SeunOjuoko/AssemblyRobot/Photos/20220331_133813.jpg

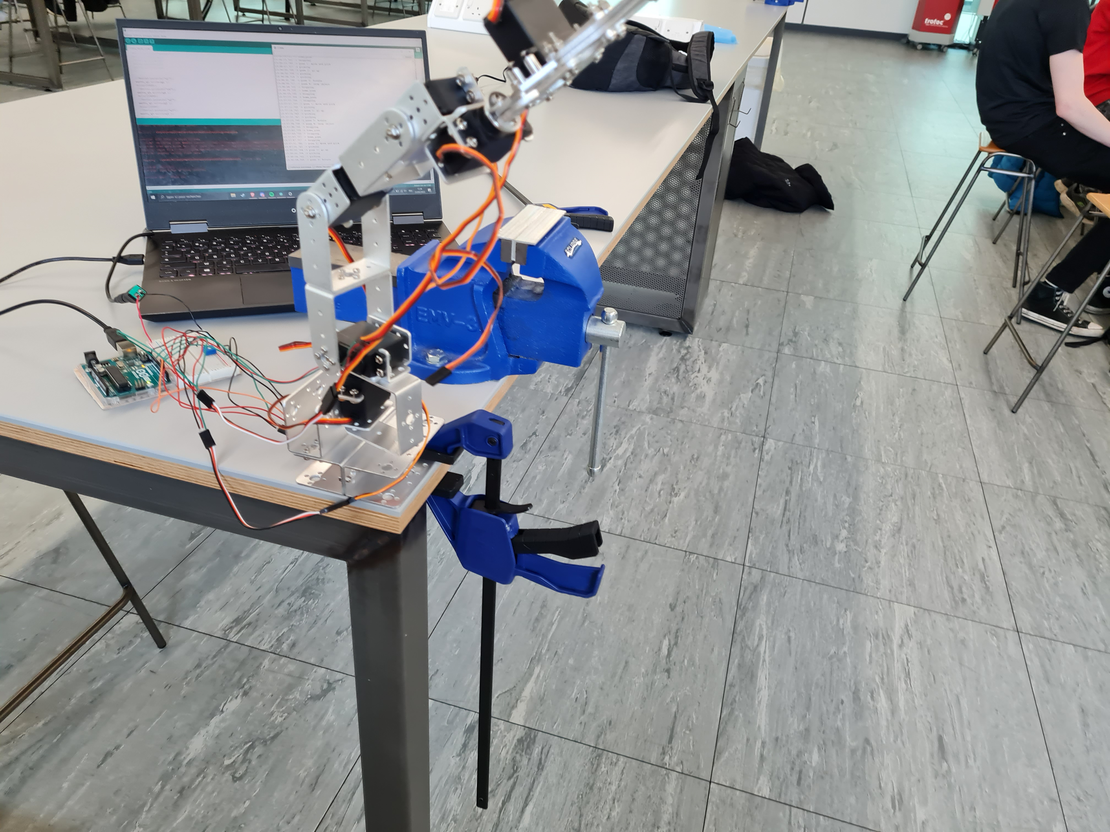
Photos/20220331_133813.jpg
