SeunOjuoko/AssemblyRobot/Photos/20220331_133640.jpg

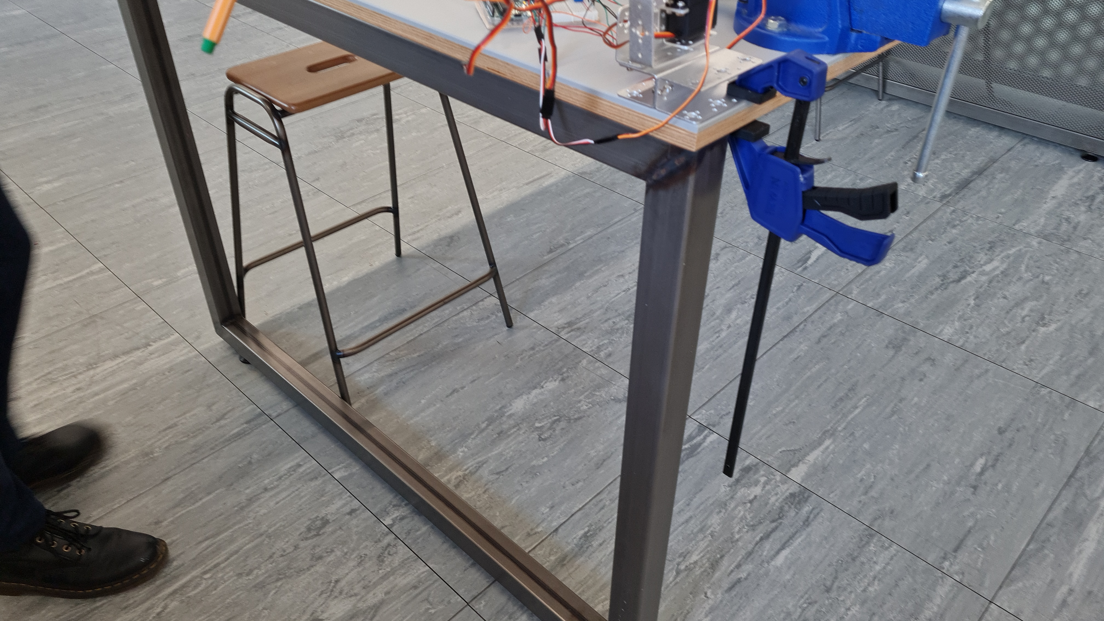
Photos/20220331_133640.jpg
