SeunOjuoko/AssemblyRobot/Electronic design link.txt

Link of the Electronic design:

https://www.tinkercad.com/things/bi56mNBK6sZ-casestudyarm/editel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
