SeunOjuoko/AssemblyRobot/More Questions for Kong.docx

1. Does the robot need to be less than £40 in parts, or is that the available budget for ordering extra parts? e.g. if we source our own servos (worth £20) and then buy a controller for £30, the robot will cost £50. Does this satisfy the requirement of the case study?
2. On that point, where can we source some spare controllers (Arduino etc.) from the uni? We've considered that the price of the controller will be a large part of the budget so would like to cut the cost.
