SeunOjuoko/AssemblyRobot/Report Plan.xlsx

Sheet: Current
Section | Description | Assigned Member(s) | Status | Notes
Abstract | -
Table of Contents | -
 |  |  |  |  | NOTE:
Introduction | Includes design brief, outline specific task, use diagrams/CAD models. | Adrian |  |  | (Adrian) I haven't really bothered to update this sheet, might just be easier to do what we did on the presentation and leave names on each section in the report.
Design 1? | Basic run through of the design, explain why rejected | Adrian
Design 2? | Basic run through of the design, explain why rejected
Design 3? | Basic run through of the design, explain why rejected | Xander
Decision Matrix |  | Adrian
Design
Chosen Design: Arm Config |  | Xander
Chosen Design: End Effector |  | Xander
some more stuff? |  | Xander
Fabrication
Material Selection |  | Xander
Fabrication/Assembly Process |  | Adrian
Costing/Bill of Parts |  | Bethany
Control
code |  | Sylvain
Simulating through tinkercad |  | Sylvain
choosing servo's |  | Zeon
choosing control board |  | Zeon
Analysis
D-H link parameters |  | Adrian
Link homogenous transformation matrix |  | Bethany
Forward Kinematics |  | Bethany
Inverse Kinematics |  | Bethany
Velocity Analysis
Static Analysis
Workspace Analysis
Robot Dynamics
Trajectory Planning
Real World Testing?
Conclusion/Discussion | -
References | - | Everyone - Harvard?
Appendices | MATLAB scripts
 | Material/Component Datasheets
 | Requistion Forms | Bethany
 | Cost Calculations | Bethany
 | Engineering Drawings
 | Arduino Scripts
 | All is WIP!
 | Copied a couple headers from the Canvas modules

Sheet: Original
Section | Description | Assigned Member(s) | Status | Notes
Abstract | -
Table of Contents | -
Introduction | Includes design brief.
Mechanism Design | Describe how mechanism was selected, how link lengths were determined.
Design/Fabrication/Testing
Design | Give assumptions, show assembled/exploded view showing main elements and design characteristics.
Fabrication | Discuss the fabrication process of the prototype.
Testing | Discuss the testing of the prototype, issues identified, improvements made in the final design. Other designs attempted.
Final Mechanical Design
 | D-H link parameters
 | Link homogenous transformation matrix
 | Forward Kinematics, show for all 5 sides, force analysis for one configuration
 | Inverse Kinematics
 | Moment Analysis
Design | Selection and design of key components including costs etc., assembled/exploded view of final design.
Manufacture | Discuss manufacturing method of at least one mechanical part in the design.
Cost Estimation | Self-explanatory.
Conclusion/Discussion | -
References | -
Appendices | Design brief sheet
 | MATLAB scripts
 | Material/Component Datasheets
 | Requistion Forms
 | Cost Calculations
 | Engineering Drawings
