SeunOjuoko/AssemblyRobot/DH Work/transformation.docx

T_1^0 =[cθ_1 , 0, -sθ_1 , 0sθ_1 , 0, cθ_1 , 00, -1, 0, 47.50, 0, 0, 1]

T_2^1 =[cθ_2 , -sθ_2 , 0, 151cθ_2 sθ_2 , cθ_2 , 0, 151sθ_2 0, 0, 1, 00, 0, 0, 1]

T_3^2 =[cθ_3 , -sθ_3 , 0, 100cθ_3 sθ_3 , cθ_3 , 0, 100sθ_3 0, 0, 1, 00, 0, 0, 1]

T_4^3 =[cθ_3 , -sθ_3 , 0, 55cθ_3 sθ_3 , cθ_3 , 0, 55sθ_3 0, 0, 1, 00, 0, 0, 1]

Then:

T_4^0 =[, , , , , , , , , , , , ]
