SeunOjuoko/AssemblyRobot/Old CAD Stuff/2nd CAD model/Gripper concept.pptx

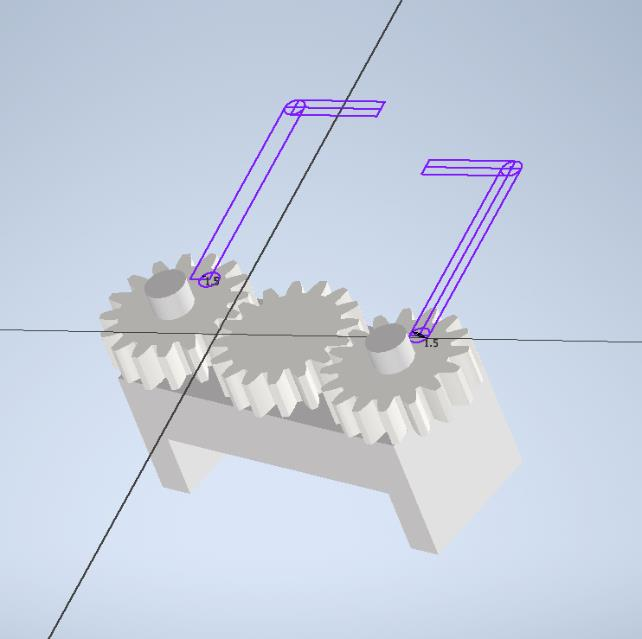
[picture p28: figure]
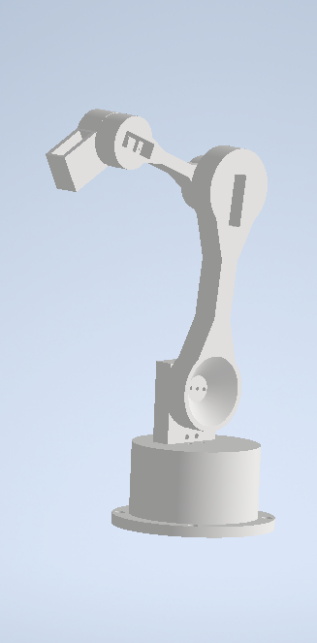
[picture p29: figure]
