SeunOjuoko/AssemblyRobot/15_Supportingfiles/circuit diagram.png

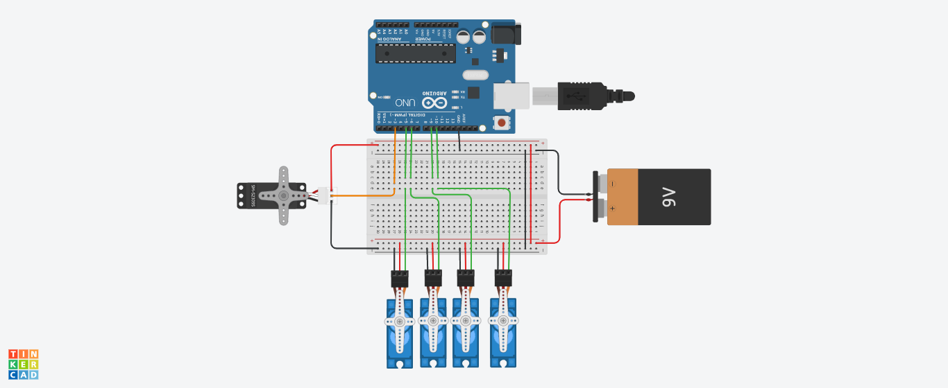
15_Supportingfiles/circuit diagram.png
