SeunOjuoko/AssemblyRobot/DH Work/robotDH.png

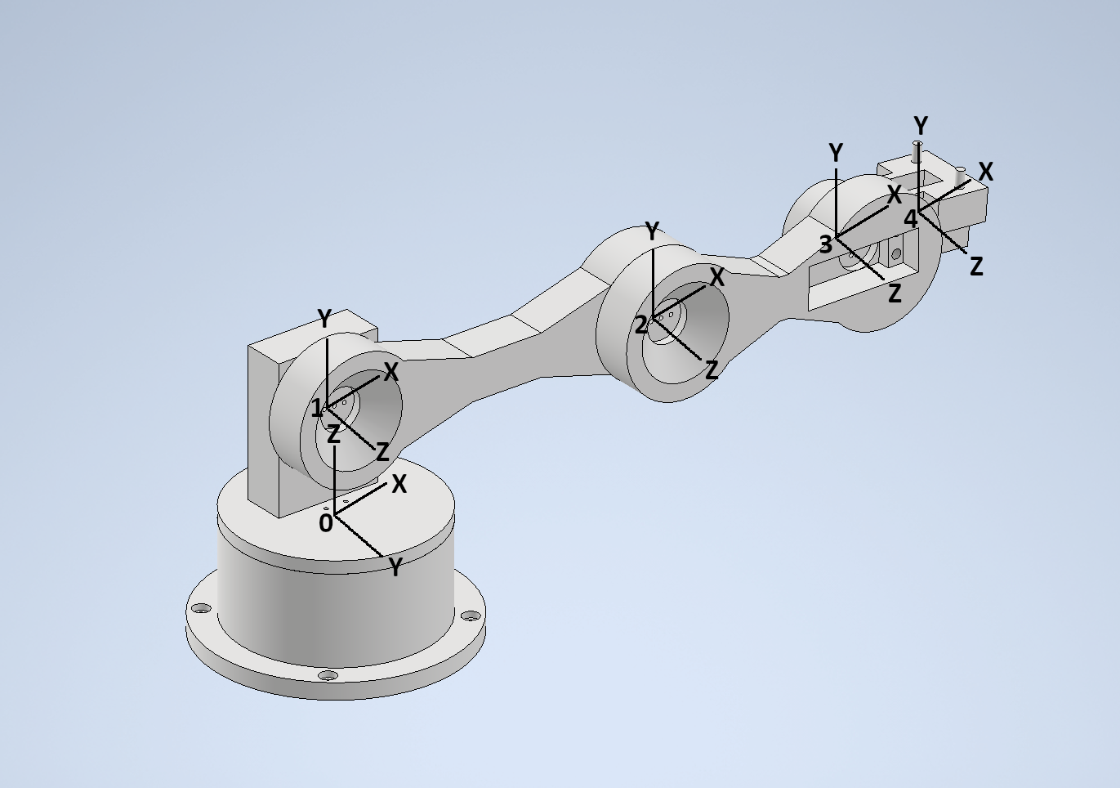
DH Work/robotDH.png
