SeunOjuoko/AssemblyRobot/Photos/20220331_124221.jpg

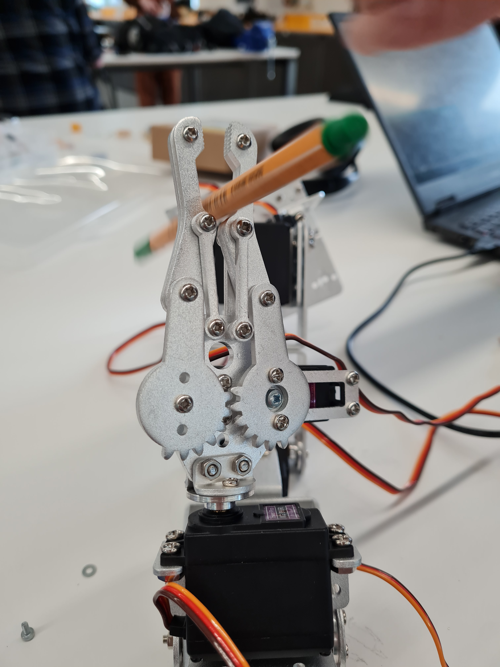
Photos/20220331_124221.jpg
