SeunOjuoko/AssemblyRobot/Photos/20220331_133649.jpg

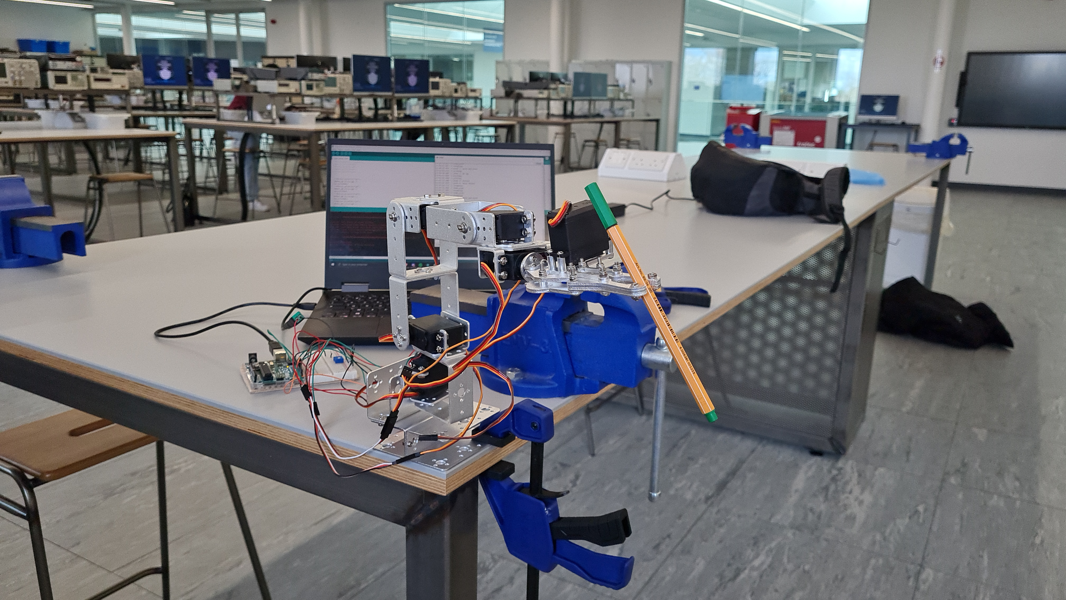
Photos/20220331_133649.jpg
