SeunOjuoko/AssemblyRobot/Photos/20220331_133751.jpg

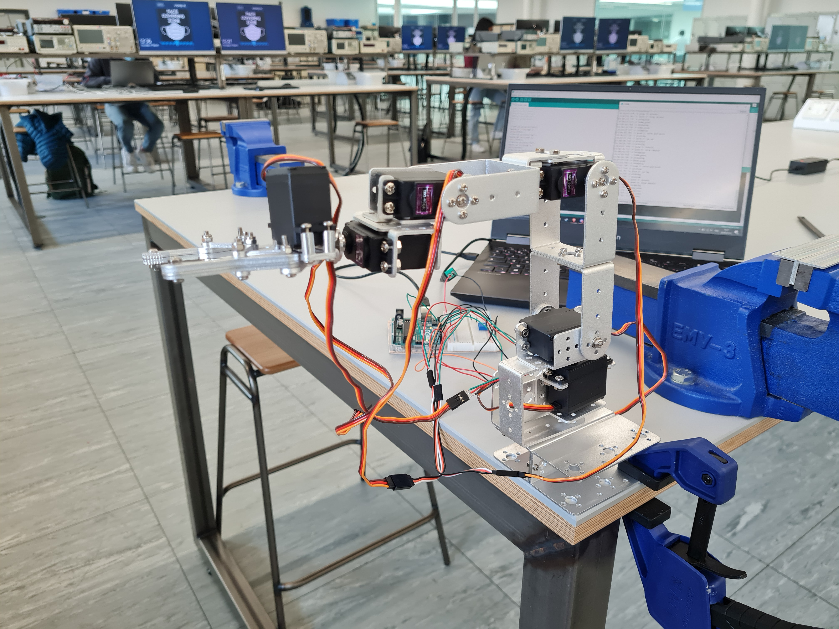
Photos/20220331_133751.jpg
