SeunOjuoko/AssemblyRobot/Photos/20220331_133758(0).jpg

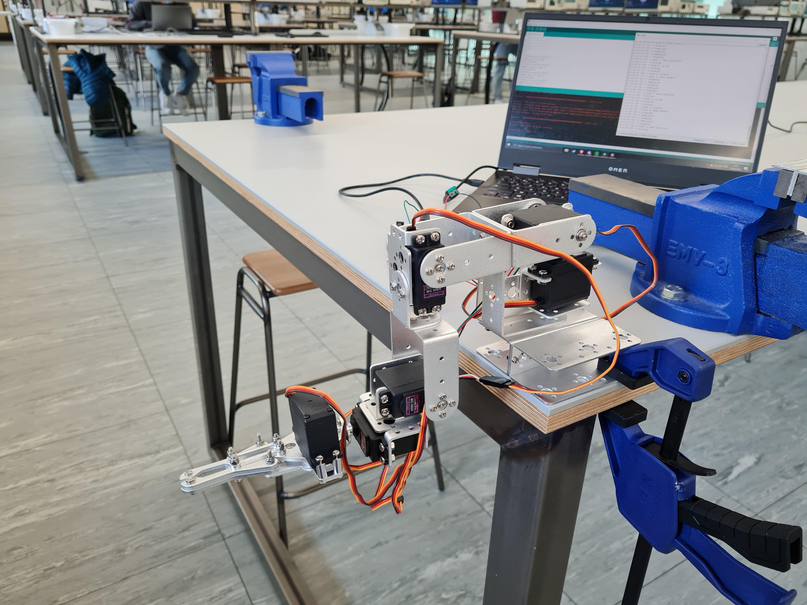
Photos/20220331_133758(0).jpg
