SeunOjuoko/AssemblyRobot/Photos/20220331_133758.jpg

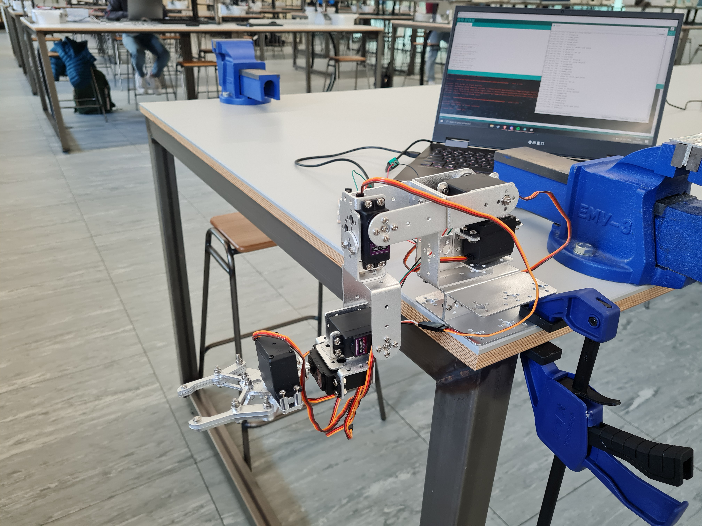
Photos/20220331_133758.jpg
