SeunOjuoko/AssemblyRobot/Photos/20220331_133807.jpg

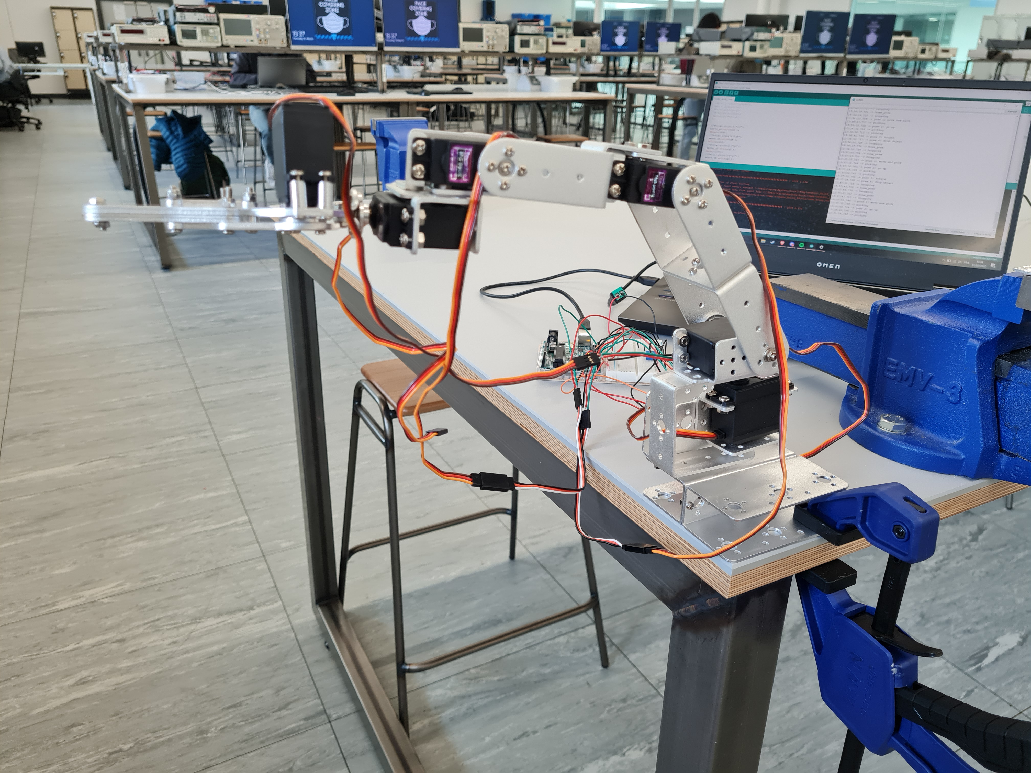
Photos/20220331_133807.jpg
