SeunOjuoko/AssemblyRobot/Photos/20220331_133810.jpg

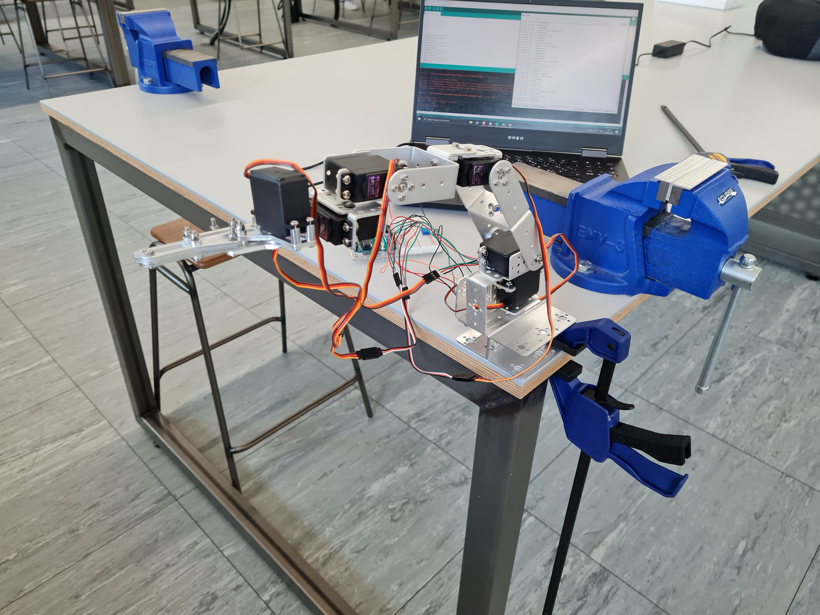
Photos/20220331_133810.jpg
