SeunOjuoko/AssemblyRobot/Photos/20220331_133815.jpg

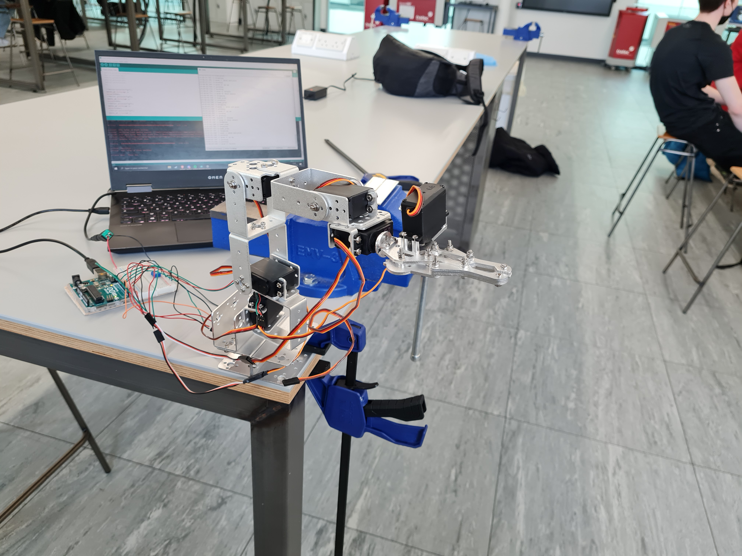
Photos/20220331_133815.jpg
