SeunOjuoko/AssemblyRobot/Photos/20220331_133825.jpg

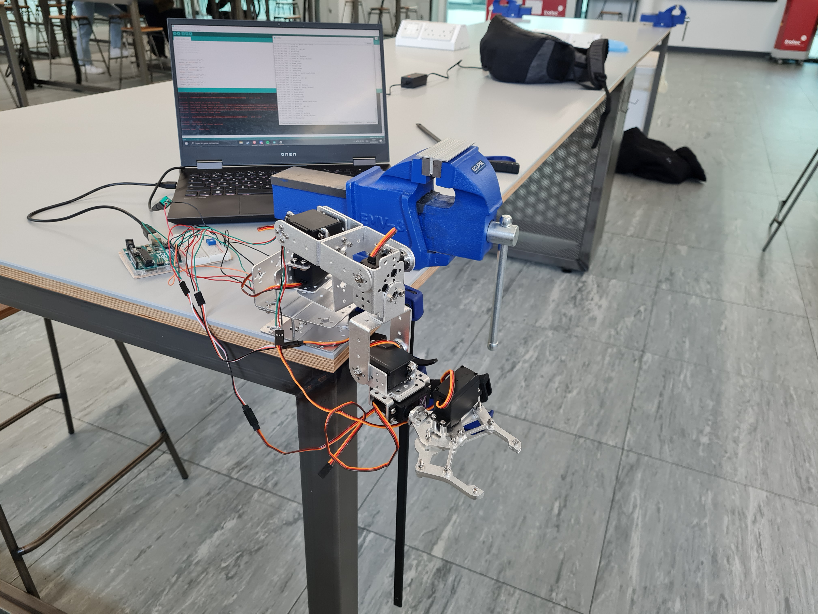
Photos/20220331_133825.jpg
