SeunOjuoko/AssemblyRobot/PresentationToDo.xlsx

 | Task | Person Assigned | Done? | Note
 | Objectives | Adrian | X
 | Mechanism Design | Xander |  | incl DOF
Modelling | Inverse Kinematics | Bethany/Sylvain |  | incl dh table, joint/link schematic
 | Schematic | Adrian
 | Forward Kinematics | Bethany/Sylvain
 | Singularity Analysis | - |  | What does this even entail?
 | Workspace Analysis | Adrian
 | Static Analysis | Adrian |  | Almost done, just need motor torques
 | Kinematic/dynamic Simulation |  |  | (Adrian) I've made a 3d animation in case we don't get any real testing footage
 | FEA |  |  | low priority
Fabrication | Component/Material Selection | Adrian | X
 | Assembly | Xander
Control | Trajectory Planning | - |  | What does this even entail?
 | Motor Control | - |  | What does this even entail?
 | Implementation | - |  | What does this even entail?
 | Testing/Evaluation | Bethany
 | Conclusion
 | Future Work | Seun (tentative)
