SeunOjuoko/AssemblyRobot/Req Form B50RO_Team_15.xlsx

Sheet: Form
 |  |  | REQUEST FOR GOODS OR SERVICES (HWU, HWT,SVL AND EBS)
Internal Use Only |  |  |  |  |  |  |  |  |  |  |  |  |  | Recommended Suppliers
This form should be used for requisitioning goods or services prior to a Purchase Order being raised |  |  |  |  |  |  |  |  |  |  |  |  |  | Electronic components:
***CHECK FUNDS ARE AVAILABLE BEFORE PROCEEDING*** |  |  |  |  |  |  |  |  |  |  |  |  |  | Onecall, RS Components, Rapid electronics
 |  |  |  |  |  |  |  |  |  |  |  |  |  | Toner or inkjet cartridges
Requisitioner: |  |  |  |  |  | Finance Regulations - Procurement Rules |  |  | Supplier Details (please complete if known) |  |  |  |  | Spectrum Ltd
Name: | Bethany | Livingstone |  |  |  | £500-£2k excl VAT- 2 Quotes Required |  |  | Name: | RS components |  |  |  | Computers and peripherals
Extn. | bll3@hw.ac.uk |  |  |  |  | £2k-£5k excl VAT - 2 Written Quotes |  |  | Address: |  |  |  |  | Insight Ltd
Dept: | B50RO Team 15 |  |  |  |  | £5k-£20k excl VAT- 3 Written Quotes |  |  |  |  |  |  |  | Chemicals & Solids
Delivery of Goods Address: |  |  |  |  |  | Over £20k - Contact Procurement Services |  |  | Phone: |  |  |  |  | Fisher Scientific, Sigma Aldrich, VWR,
 |  |  |  |  |  | e-mail: procurement@hw.ac.uk |  |  | Fax:
 |  |  |  |  |  |  |  |  | Order FAO. |  |  |  |  | Speak to stores for advice DO NOT use Web based Suppliers unless
 |  |  |  |  |  |  |  |  |  |  |  |  |  | approved suppliers cannot supply goods.
Qty | Catalogue /Part No. | Type of Goods/Services |  | Description of Goods or Services (please attach any quote) |  |  |  |  |  |  | Unit Cost | Sub Total | VAT amount (note only)
1 | 204-9891 | Servo motor |  | Mini 180 degree resin gear servo sg90 |  |  |  |  |  |  | £2.95 | £2.95 | £0.59 | Where foreign currency is used just submit in USD, EURO etc Do Not
1 | 200-9387 | 3d printing material |  | polymaker 1.75mm PLA Black 3D Printer filament. 1Kg |  |  |  |  |  |  | £24.09 | £24.09 | £4.82 | convert to GBP.
 |  |  |  |  |  |  |  |  |  |  | £0.00 | £0.00 | £0.00
 |  |  |  |  |  |  |  |  |  |  | £0.00 | £0.00 | £0.00
 |  |  |  |  |  |  |  |  |  |  | £0.00 | £0.00 | £0.00
 |  |  |  |  |  |  |  |  |  |  | £0.00 | £0.00 | £0.00
 |  |  |  |  |  |  |  |  |  |  | £0.00 | £0.00 | £0.00
 |  |  |  |  |  |  |  |  |  |  | £0.00 | £0.00 | £0.00
 |  |  |  |  |  |  | Delivery Charge (if charged - insert total) |  |  |  |  | £4.95 | £0.99
See below for updated Business units, Nominal Codes, Job codes and Research Codes |  |  |  |  |  |  |  |  |  | Total |  | £31.99
I.T. Purchases MUST be authorised by Hugh Conner before completing this form |  |  |  |  |  |  |  |  |  | VAT (if applicable - calculated on total above) |  | £6.40
** Requisition Forms Must be signed by Budget Holder before submitting to Stores** |  |  |  |  |  |  |  |  |  | Grand Total |  | £38.39
Budget holder: |  |  |  |  |  | Date:
IT Authorisation: |  |  |  |  |  | Date:
ORACLE CODES - ORDERS CANNOT BE PLACED WITHOUT THIS INFORMATION |  |  |  |  |  |  |  |  |  |  | Office Use only
Entity: HWU |  | Business Unit | Cost Centre | Nominal Account | Activity Code | Product Code | Job Code |  | Project Code |  | VISA Order No
HWU |  | 1240 |  |  | T11 | Not Applicable | A0132 |  |  |  | O12 Order no.
 |  |  |  |  |  |  |  |  |  |  | Date input:
 |  |  |  |  |  |  |  |  |  |  | Input by:
 |  |  |  |  |  |  |  |  | See across
Business Unit Numbers |  |  | Nominal Codes |  |  |  | Job Code | Description |  |  |  |  |  | Research code | Budget Holder | Activity |  | Bus Unit | Start | End
Chemical Eng 1210 |  |  | Lab Consumables 5215 |  |  |  | B99A0130 | EPS-STUDENT DEMONSTRATORS |  |  |  |  |  | B00R00001 | EPSRC-Paterson-11/14 | R20 | Research | 1270 | 2011-12-01 | 2014-11-30
Chemistry 1220 |  |  | IT Consumables 5225 |  |  |  | B99A0131 | EPS - ADMIN EQUIP (Changed to Formula Student 09/09) |  |  |  |  |  | B00R00002 | EPSRC-Wang-07/12 | R20 | Research | 1274 | 2009-08-01 | 2012-11-30
Physics 1230 |  |  | First Aid 5230 |  |  |  | B99A0132 | EPS- PROJECTS |  |  |  |  |  | B00R00003 | NERC-Chen B-03/13 | R25 | Research | 1278 | 2010-04-01 | 2013-09-30
Mech Eng 1240 |  |  | Clothing 5235 |  |  |  | B99A0134 | EPS - TEACHING LABS (PRACTICAL) |  |  |  |  |  | B00R00004 | EPSRC-Kong-12/12 | R20 | Research | 1278 | 2011-07-06 | 2013-01-31
Elect Eng 1250 |  |  | IT H/Ware 5310 |  |  |  | B99A0135 | EPS - COPYRIGHT RECHARGES |  |  |  |  |  | B00R00005 | EPSRC-Reuben-8/15 | R20 | Research | 1278 | 2012-02-20 | 2015-08-18
Combined Studies 1260 |  |  | Equipment 5255 |  |  |  | B99A0136 | EPS-TEACHING LABS (COMP) |  |  |  |  |  | B00R00006 | EPSRC-Buller-07/14 | R20 | Research | 1276 | 2010-09-21 | 2014-07-09
Inst of Chemical Science1270 |  |  | IT H/Ware Maint 5315 |  |  |  | B99A0137 | EPS-U/G VAC GRANTS |  |  |  |  |  | B00R00007 | STFC-Greenaway-01/13 | R26 | Research | 1272 | 2012-02-01 | 2013-01-31
IB3 1272 |  |  | IT H/Ware Leasing 5320 |  |  |  | B99A0138 | EPS-U/G SCHOLARSHIPS |  |  |  |  |  | B00R00008 | EPSRC-Ohberg-5/15 | R20 | Research | 1276 | 2012-06-01 | 2015-05-31
ISSS 1274 |  |  | IT S/Ware 5325 |  |  |  | B99A0139 | EPS-EXTERNAL EXAMINER U/GT & P/GT |  |  |  |  |  | B00R00009 | EPSRC-Prior-04/13 | R20 | Research | 1276 | 2012-02-01 | 2013-04-30
IPAQS 1276 |  |  | S/Ware Licences 5330 |  |  |  | B99A0141 | EPS-STAFF TRAVEL T&L |  |  |  |  |  | B06R00006 | EPSRC-McKendrick-30/09/12 | R20 | Linked to 111137, 111142, 111407 | 1270 | 2006-10-01 | 2012-09-30
IMPEE 1278 |  |  | Repair & Maint 5430 |  |  |  | B99A0142 | EPS-IND ADVISORY COMM EXPS |  |  |  |  |  | B06R00007 | EPSRC-MCKENDRICK-30/09/12 | R20 | Linked to 111136, 111142, 111407 | 1270 | 2006-10-01 | 2012-12-31
Central & Core 1299 |  |  | Telephones 6230 |  |  |  | B99A0143 | EPS- UG Fee Exemptions |  |  |  |  |  | B07R00009 | Renishaw (SA)-Hand-03/11 | R70 | Linked project parent code = 111089 | 1276 | 2007-09-01 | 2013-03-31
 |  |  | Postage & Feight 6220 |  |  |  | B99A0144 | EPS-UG Stipend |  |  |  |  |  | B08R00005 | EPSRC-IMRC-Jones-03/13 | R20 | Research | 1276 | 2008-04-01 | 2013-03-31
 |  |  | Books 6320 |  |  |  | B99A0145 | EPS-U/G RECRUITMENT |  |  |  |  |  | B08R00011 | EPSRC(RAE)-Clark-06/13 | R65 | Research | 1274 | 2008-07-01 | 2013-06-30
 |  |  | Print & Stationery 6210 |  |  |  | B99A0146 | EPS-SEMINAR SPEAKERS |  |  |  |  |  | B08R00018 | Aber Instruments-Markx-09/11 | R70 | Research | 1272 | 2008-10-01 | 2012-09-30
 |  |  | Vehicle costs 5810 |  |  |  | B99A0147 | EPS-EXT EXAMINERS RESEARCH |  |  |  |  |  | B08R00021 | EPSRC-Buller-04/12 | R20 | Research | 1276 | 2008-09-26 | 2012-12-31
 |  |  | Travel & Subsist 5815 |  |  |  | B99A0148 | EPS-P/GR RECRUITMENT |  |  |  |  |  | B08R00022 | RSE/Scot Gov - Bookey-09/11 | R70 | Research | 1276 | 2008-10-01 | 2013-09-30
 |  |  | Hospitatility 5820 |  |  |  | B99A0149 | EPS-CENTRAL RESEARCH DEVELOPMENT |  |  |  |  |  | B08R00025 | EU-FAMOBS-Desmulliez-05/10 | R35 | Exp bearing project | 1278 | 2008-11-01 | 2012-10-09
 |  |  | Waste Disposal 5450 |  |  |  | B99A0150 | EPS-RESEARCH STAFF TRAVEL |  |  |  |  |  | B08R00027 | EPSRC/White/24.11.13 | R20 | Research | 1278 | 2008-11-25 | 2014-08-31
 |  |  | Training & Conf's 6310 |  |  |  | B99A0151 | EPS-ACADEMIC HEADS |  |  |  |  |  | B08S00001 | SFC-White-31/07/2013 | R60 | SRDG | 1278 | 2008-08-01 | 2013-07-31
 |  |  |  |  |  |  | B99A0153 | EPS-PG FEE ABATEMENTS |  |  |  |  |  | B09R00004 | EPSRC-IMRC-Moore-12/11 | R20 | Research | 1276 | 2009-01-01 | 2013-03-31
 |  |  |  |  |  |  |  |  |  |  |  |  |  | B09R00005 | EPSRC-IMRC-Desmulliez-05/12 | R20 | Research | 1274 | 2009-02-01 | 2012-12-31
 |  |  |  |  |  |  |  |  |  |  |  |  |  | B09R00006 | EPSRC-IMRC-Ritchie-08/12 | R20 | Research | 1278 | 2009-02-01 | 2013-03-31
 |  |  |  |  |  |  |  |  |  |  |  |  |  | B09R00007 | EPSRC-McKendrick-08/12 | R20 | Research | 1270 | 2009-03-01 | 2013-02-28
 |  |  |  |  |  |  |  |  |  |  |  |  |  | B09R00009 | EPSRC - Kar - 09/12 | R20 | Research | 1276 | 2009-04-01 | 2013-03-31
 |  |  |  |  |  |  |  |  |  |  |  |  |  | B09R00012 | Carnegie Trust-Ohberg-05/12 | R65 | Research | 1276 | 2009-06-01 | 2012-12-31
 |  |  |  |  |  |  |  |  |  |  |  |  |  | B09R00015 | EPSRC-IMRC-Hand1-09/12 | R20 | Research | 1276 | 2009-06-07 | 2013-03-31
 |  |  |  |  |  |  |  |  |  |  |  |  |  | B09R00016 | BBSRC-Willoughby-06/12 | R21 | Research | 1272 | 2009-06-11 | 2012-10-26
 |  |  |  |  |  |  |  |  |  |  |  |  |  | B09R00019 | EPSRC-Buller-08/11 | R20 | Research | 1276 | 2009-06-30 | 2012-12-29
 |  |  |  |  |  |  |  |  |  |  |  |  |  | B09R00023 | EPSRC-Shephard-12/11 | R20 | Research | 1276 | 2009-07-13 | 2013-01-12
 |  |  |  |  |  |  |  |  |  |  |  |  |  | B09R00024 | Japan NUS-Chen-03/10 | R80 | Expenditure bearing project | 1278 | 2009-06-15 | 2015-03-31
 |  |  |  |  |  |  |  |  |  |  |  |  |  | B09R00029 | PowerPhotonic-Baker-09/13 | R70 | Research | 1278 | 2009-09-08 | 2013-09-07
 |  |  |  |  |  |  |  |  |  |  |  |  |  | B09R00031 | EPSRC-IMRC-Moore-03/13 | R20 | Research | 1276 | 2009-10-01 | 2013-03-31
 |  |  |  |  |  |  |  |  |  |  |  |  |  | B09R00032 | EPSRC-Buller-09/12 | R20 | Research | 1276 | 2009-10-01 | 2012-12-31
 |  |  |  |  |  |  |  |  |  |  |  |  |  | B09R00033 | RS-Gerardot-09/14 | R27 | Research | 1276 | 2009-10-01 | 2014-09-30
 |  |  |  |  |  |  |  |  |  |  |  |  |  | B09R00035 | Rofin-Hall-09/13 | R70 | Research | 1276 | 2009-10-09 | 2013-10-08
 |  |  |  |  |  |  |  |  |  |  |  |  |  | B09R00036 | EPSRC(DSTL)-Petillot-12/11 | R20 | Research | 1274 | 2009-10-19 | 2013-01-31
 |  |  |  |  |  |  |  |  |  |  |  |  |  | B09R00037 | EPSRC-IMRC-Desmulliez-4/12 | R20 | Research | 1274 | 2009-11-01 | 2013-03-31
 |  |  |  |  |  |  |  |  |  |  |  |  |  | B09R00038 | STFC-Greenaway-08/12 | R26 | Research | 1272 | 2009-11-02 | 2012-11-01
 |  |  |  |  |  |  |  |  |  |  |  |  |  | B09R00039 | BAE-MacPherson-11/13 | R70 | Research | 1276 | 2009-11-25 | 2013-11-24
 |  |  |  |  |  |  |  |  |  |  |  |  |  | B09S00001 | SUPA II - Greenhalgh - | R60 | SRDG | 1276 | 2010-06-01 | 2017-07-31
 |  |  |  |  |  |  |  |  |  |  |  |  |  | B10R00001 | EC*-TRIDENT - Petillot - 12/12 | R35 | Project for Euro Receipts only | 1274 | 2010-10-01 | 2012-12-31
 |  |  |  |  |  |  |  |  |  |  |  |  |  | B10R00005 | EPSRC-Reid-3/13 | R20 | Research | 1276 | 2009-12-31 | 2013-06-30
 |  |  |  |  |  |  |  |  |  |  |  |  |  | B10R00008 | EC- LASSIE - McCoustra-01/14 | R35 | Research | 1270 | 2010-02-01 | 2014-01-31
 |  |  |  |  |  |  |  |  |  |  |  |  |  | B10R00009 | EC* LASSIE- -McCoustra-01/14 | R35 | Project for Euro Receipts Only | 1270 | 2010-02-01 | 2014-01-31
 |  |  |  |  |  |  |  |  |  |  |  |  |  | B10R00011 | EPSRC(NPL)-Reid-01/13 | R20 | Research | 1276 | 2010-02-01 | 2013-01-31
 |  |  |  |  |  |  |  |  |  |  |  |  |  | B10R00014 | EC-TRIDENT-Petillot-02/13 | R35 | Research | 1274 | 2010-03-01 | 2013-02-28
 |  |  |  |  |  |  |  |  |  |  |  |  |  | B10R00015 | IeMRC-Desmulliez-02/15 | R20 | Research | 1278 | 2010-03-01 | 2015-02-28
 |  |  |  |  |  |  |  |  |  |  |  |  |  | B10R00019 | EC-MultiWaveS-Hong-03/14 | R35 | Expenditure bearing project | 1274 | 2010-04-01 | 2014-03-31
 |  |  |  |  |  |  |  |  |  |  |  |  |  | B10R00021 | EC*-MultiWaveS-Hong-03/14 | R35 | Euro receipts project only | 1274 | 2010-04-01 | 2014-03-31
 |  |  |  |  |  |  |  |  |  |  |  |  |  | B10R00022 | AWE-Cumber-09/13 | R70 | Research | 1278 | 2009-10-01 | 2013-09-30
 |  |  |  |  |  |  |  |  |  |  |  |  |  | B10R00023 | EPSRC-IMRC-Lim1-03/13 | R20 | Research | 1278 | 2010-04-01 | 2013-03-31
 |  |  |  |  |  |  |  |  |  |  |  |  |  | B10R00025 | EPSRC-Dalgarno-04/13 | R20 | Research | 1270 | 2010-04-12 | 2013-04-25
 |  |  |  |  |  |  |  |  |  |  |  |  |  | B10R00028 | EPSRC-IMRC-Baker1-03/13 | R20 | Research | 1276 | 2010-05-01 | 2013-03-31
 |  |  |  |  |  |  |  |  |  |  |  |  |  | B10R00034 | EC-NanoSpec-Richards-05/13 | R35 | Expenditure bearing project | 1276 | 2010-06-01 | 2013-05-31
 |  |  |  |  |  |  |  |  |  |  |  |  |  | B10R00035 | EC* - NanoSpec-Richards-6/13 | R35 | Project for Euro Receipts only | 1276 | 2010-06-01 | 2013-05-31
 |  |  |  |  |  |  |  |  |  |  |  |  |  | B10R00036 | STFC-Thomson-05/15 | R26 | Research | 1276 | 2010-06-01 | 2015-05-31
 |  |  |  |  |  |  |  |  |  |  |  |  |  | B10R00037 | EC-MiSPIA-Taghizadeh-05/13 | R35 | Expenditure Bearing Account | 1276 | 2010-06-01 | 2013-05-31
 |  |  |  |  |  |  |  |  |  |  |  |  |  | B10R00038 | EPSRC-IMRC-Baker2-03/13 | R20 | Research | 1276 | 2010-06-01 | 2013-03-31
 |  |  |  |  |  |  |  |  |  |  |  |  |  | B10R00039 | Rofin Sinar-Baker-10/13 | R70 | Research | 1276 | 2010-06-01 | 2013-10-31
 |  |  |  |  |  |  |  |  |  |  |  |  |  | B10R00040 | EC*-Taghizadeh-06/13 | R35 | Euro Receipts Project Only | 1276 | 2010-06-01 | 2013-05-31
 |  |  |  |  |  |  |  |  |  |  |  |  |  | B10R00044 | EC*-XChem-Paterson-07/15 | R35 | Project for Euro Receipts only | 1270 | 2010-08-01 | 2015-07-31
 |  |  |  |  |  |  |  |  |  |  |  |  |  | B10R00049 | STFC-Luo-09/14 | R26 | Research | 1278 | 2010-07-01 | 2014-09-30
 |  |  |  |  |  |  |  |  |  |  |  |  |  | B10R00055 | EC-XChem-Paterson-07/15 | R35 | Research | 1270 | 2010-08-01 | 2015-07-31
 |  |  |  |  |  |  |  |  |  |  |  |  |  | B10R00056 | EC-LOCOBOT-Wallace-06/13 | R35 | Research | 1274 | 2010-08-01 | 2013-07-31
 |  |  |  |  |  |  |  |  |  |  |  |  |  | B10R00057 | EC*-LOCOBOT-Wallace-07/13 | R35 | Project for Euro Receipts only | 1274 | 2010-08-01 | 2013-07-31
 |  |  |  |  |  |  |  |  |  |  |  |  |  | B10R00063 | Seebyte-Petillot-09/15 | R70 | Research | 1274 | 2010-09-13 | 2015-09-13
 |  |  |  |  |  |  |  |  |  |  |  |  |  | B10R00064 | Thales-Wallace-09/15 | R70 | Research | 1274 | 2010-09-13 | 2015-09-12
 |  |  |  |  |  |  |  |  |  |  |  |  |  | B10R00065 | RCN-Chen-09/14 | R40 | Research | 1278 | 2010-09-20 | 2014-09-19
 |  |  |  |  |  |  |  |  |  |  |  |  |  | B10R00068 | Leverhulme-Lee-12/12 | R65 | Research | 1270 | 2010-10-01 | 2012-12-31
 |  |  |  |  |  |  |  |  |  |  |  |  |  | B10R00069 | Leverhulme-Bebbington-09/12 | R65 | Research | 1270 | 2010-10-01 | 2012-11-03
 |  |  |  |  |  |  |  |  |  |  |  |  |  | B10R00071 | IeMRC(L'boro)-Desmulliez-03/14 | R20 | Research | 1274 | 2010-10-01 | 2014-03-31
 |  |  |  |  |  |  |  |  |  |  |  |  |  | B10R00074 | EC-GaLA-Lim-06/13 | R35 | Expenditure bearing project | 1278 | 2010-10-01 | 2014-09-30
 |  |  |  |  |  |  |  |  |  |  |  |  |  | B10R00075 | Leverhulme-Richards-09/13 | R65 | Research | 1276 | 2010-09-24 | 2013-09-30
 |  |  |  |  |  |  |  |  |  |  |  |  |  | B10R00076 | Sgurr Energy-Fruh-03/14 | R70 | Research | 1278 | 2010-10-01 | 2014-04-01
 |  |  |  |  |  |  |  |  |  |  |  |  |  | B10R00077 | EC*-GALA-Lim-06/13 | R35 | Project for Euro Receipts only | 1278 | 2010-10-01 | 2013-06-30
 |  |  |  |  |  |  |  |  |  |  |  |  |  | B10R00078 | Leverhulme-Reid-03/14 | R65 | Research | 1276 | 2010-10-01 | 2014-03-31
 |  |  |  |  |  |  |  |  |  |  |  |  |  | B10R00079 | EPSRC-Buller-09/13 | R20 | Research | 1276 | 2010-10-01 | 2013-09-30
 |  |  |  |  |  |  |  |  |  |  |  |  |  | B10R00080 | Royal Society-Lovett-09/11 | R27 | Research | 1276 | 2010-10-01 | 2014-09-30
 |  |  |  |  |  |  |  |  |  |  |  |  |  | B10R00081 | Taylor Hobson-Kar-09/14 | R70 | Research | 1276 | 2010-10-01 | 2014-09-30
 |  |  |  |  |  |  |  |  |  |  |  |  |  | B10R00082 | Renishaw-Hand-03/14 | R70 | Research | 1276 | 2010-10-01 | 2014-03-31
 |  |  |  |  |  |  |  |  |  |  |  |  |  | B10R00085 | EPSRC-IMRC-Desmulliez-03/13 | R20 | Research | 1274 | 2010-11-01 | 2013-03-31
 |  |  |  |  |  |  |  |  |  |  |  |  |  | B10R00089 | DCG(IARPA)-Reid-11/14 | R45 | Research | 1276 | 2010-11-10 | 2014-11-09
 |  |  |  |  |  |  |  |  |  |  |  |  |  | B10R00090 | Renishaw SA-MacPherson-10/13 | R70 | Research | 1276 | 2010-11-10 | 2013-11-09
 |  |  |  |  |  |  |  |  |  |  |  |  |  | B10R00092 | Huawei Tech-WangCX-12/11 | R75 | Research | 1274 | 2010-12-06 | 2013-01-31
 |  |  |  |  |  |  |  |  |  |  |  |  |  | B10S00001 | SFC(SPIRIT)-Ni-02/14 | R60 | SRDG | 1278 | 2010-09-01 | 2014-02-28
 |  |  |  |  |  |  |  |  |  |  |  |  |  | B10S00002 | SFC(Dundee)-Shu-03/14 | R60 | SRDG | 1272 | 2010-10-01 | 2014-03-31
 |  |  |  |  |  |  |  |  |  |  |  |  |  | B10S00003 | ETP-Fruh-03/14 | R60 | SRDG | 1278 | 2010-10-01 | 2014-03-31
 |  |  |  |  |  |  |  |  |  |  |  |  |  | B11N00001 | BB-KTP-Ritchie-01/14 | O12 | Expenditure bearing project | 1278 | 2011-01-17 | 2014-01-16
 |  |  |  |  |  |  |  |  |  |  |  |  |  | B11N00006 | Progress Rail-Ritchie-01/14 | O12 | Non Research | 1278 | 2011-01-17 | 2014-01-16
 |  |  |  |  |  |  |  |  |  |  |  |  |  | B11N00007 | KTP-Ritchie-01/14 | O12 | Non Research | 1278 | 2011-01-17 | 2014-01-16
 |  |  |  |  |  |  |  |  |  |  |  |  |  | B11N00008 | ERDF(StrathUni)-Richards-11/14 | O13 | Non Research | 1276 | 2011-12-01 | 2014-11-30
 |  |  |  |  |  |  |  |  |  |  |  |  |  | B11N00009 | EPSRC(IS)-Maniscalco-10/12 | R20 | Non Research | 1276 | 2012-05-01 | 2013-03-31
 |  |  |  |  |  |  |  |  |  |  |  |  |  | B11R00001 | Thales-Robertson-06/14 | R70 | Research | 1274 | 2011-01-01 | 2014-06-30
 |  |  |  |  |  |  |  |  |  |  |  |  |  | B11R00003 | MRC-Duncan-04/13 | R24 | Research | 1272 | 2010-01-05 | 2014-01-04
 |  |  |  |  |  |  |  |  |  |  |  |  |  | B11R00004 | Wellcome Trust-Duncan-01/14 | R65 | Research | 1272 | 2011-01-05 | 2014-01-04
 |  |  |  |  |  |  |  |  |  |  |  |  |  | B11R00008 | EPSRC-Richards-12/13 | R20 | Research | 1276 | 2011-01-25 | 2014-08-05
 |  |  |  |  |  |  |  |  |  |  |  |  |  | B11R00010 | RS-Welch-02/14 | R27 | Research | 1270 | 2011-02-14 | 2014-02-13
 |  |  |  |  |  |  |  |  |  |  |  |  |  | B11R00012 | RS-Kong-02/13 | R27 | Research | 1278 | 2011-02-28 | 2013-02-27
 |  |  |  |  |  |  |  |  |  |  |  |  |  | B11R00014 | RS-Maier-02/13 | R27 | Research | 1276 | 2011-03-01 | 2013-02-28
 |  |  |  |  |  |  |  |  |  |  |  |  |  | B11R00015 | RS-Kar-03/13 | R27 | Research | 1276 | 2011-03-15 | 2013-03-14
 |  |  |  |  |  |  |  |  |  |  |  |  |  | B11R00016 | RS-Gerardot-03/13 | R27 | Research | 1276 | 2011-03-31 | 2013-03-29
 |  |  |  |  |  |  |  |  |  |  |  |  |  | B11R00017 | RSE-Wang Xu-03/13 | R27 | Research | 1274 | 2011-04-01 | 2013-03-31
 |  |  |  |  |  |  |  |  |  |  |  |  |  | B11R00019 | EPSRC-IMRC-Lim2-03/13 | R20 | Research | 1278 | 2011-04-01 | 2013-03-31
 |  |  |  |  |  |  |  |  |  |  |  |  |  | B11R00020 | EPSRC-IMRC-Hand2-09/12 | R20 | Research | 1276 | 2011-04-01 | 2012-12-31
 |  |  |  |  |  |  |  |  |  |  |  |  |  | B11R00021 | EPSRC-IMRC-Hand-03/13 | R20 | Research | 1276 | 2011-04-01 | 2013-03-31
 |  |  |  |  |  |  |  |  |  |  |  |  |  | B11R00022 | Renishaw-Hand-03/13 | R70 | Research | 1276 | 2011-04-01 | 2013-03-31
 |  |  |  |  |  |  |  |  |  |  |  |  |  | B11R00023 | NPL-Kar-03/15 | R70 | Research | 1276 | 2011-04-01 | 2016-03-31
 |  |  |  |  |  |  |  |  |  |  |  |  |  | B11R00024 | EC-ECO2-Chen-12/14 | R35 | Expenditure bearing project | 1278 | 2011-05-01 | 2015-04-30
 |  |  |  |  |  |  |  |  |  |  |  |  |  | B11R00025 | NaREC-Mallick-10/14 | R70 | Research | 1278 | 2011-05-01 | 2014-10-31
 |  |  |  |  |  |  |  |  |  |  |  |  |  | B11R00026 | EC*-ECO2-Chen-04/15 | R35 | EURO RECEIPTS PROJECT ONLY | 1278 | 2011-05-01 | 2015-04-30
 |  |  |  |  |  |  |  |  |  |  |  |  |  | B11R00027 | AWE(SA)-Taghizadeh-10/12 | R70 | Research | 1276 | 2011-05-01 | 2012-12-31
 |  |  |  |  |  |  |  |  |  |  |  |  |  | B11R00028 | EPSRC-Gerardot-04/16 | R20 | Research | 1276 | 2011-05-01 | 2016-04-30
 |  |  |  |  |  |  |  |  |  |  |  |  |  | B11R00030 | Hutchison3G-WangCX-05/14 | R70 | Research | 1274 | 2011-06-01 | 2014-05-31
 |  |  |  |  |  |  |  |  |  |  |  |  |  | B11R00031 | EPSRC-IMRC-Luo-03/13 | R20 | Research | 1278 | 2011-06-01 | 2013-03-31
 |  |  |  |  |  |  |  |  |  |  |  |  |  | B11R00034 | EPSRC-Dalgarno-06/14 | R20 | Research | 1270 | 2011-06-06 | 2014-06-05
 |  |  |  |  |  |  |  |  |  |  |  |  |  | B11R00035 | M-Solv-Shephard-06/15 | R70 | Research | 1276 | 2011-06-06 | 2015-06-05
 |  |  |  |  |  |  |  |  |  |  |  |  |  | B11R00041 | Renishaw (SA)-Thomson-09/11 | R70 | Research | 1276 | 2011-07-01 | 2012-09-30
 |  |  |  |  |  |  |  |  |  |  |  |  |  | B11R00042 | Leverhulme-Paterson-3/15 | R65 | Research | 1270 | 2011-08-31 | 2015-03-31
 |  |  |  |  |  |  |  |  |  |  |  |  |  | B11R00044 | European Thermo-Vaqueiro-02/15 | R70 | Research | 1270 | 2011-09-01 | 2015-02-28
 |  |  |  |  |  |  |  |  |  |  |  |  |  | B11R00045 | DCNS-Clark-10/14 | R80 | Research | 1274 | 2011-09-01 | 2014-10-31
 |  |  |  |  |  |  |  |  |  |  |  |  |  | B11R00048 | EPSRC(NSF)-Lovett-08/15 | R20 | Research | 1276 | 2011-09-01 | 2015-08-31
 |  |  |  |  |  |  |  |  |  |  |  |  |  | B11R00049 | EOARD-Hadfield 2/13 | R45 | Research | 1276 | 2011-09-01 | 2012-10-31
 |  |  |  |  |  |  |  |  |  |  |  |  |  | B11R00050 | MESL-Hong-9/15 | R70 | Research | 1274 | 2011-09-12 | 2015-09-11
 |  |  |  |  |  |  |  |  |  |  |  |  |  | B11R00051 | EPSRC-Bos-09/13 | R20 | Research | 1270 | 2011-07-01 | 2013-09-12
 |  |  |  |  |  |  |  |  |  |  |  |  |  | B11R00052 | SU2P-Hadfield-09/12 | R21 | Research | 1276 | 2011-09-22 | 2012-09-30
 |  |  |  |  |  |  |  |  |  |  |  |  |  | B11R00054 | DWQRS-Richards-03/15 | R70 | Research | 1276 | 2011-10-01 | 2015-03-31
 |  |  |  |  |  |  |  |  |  |  |  |  |  | B11R00055 | NNL-McNeil-03/12 | R70 | Research | 1278 | 2011-10-01 | 2012-12-31
 |  |  |  |  |  |  |  |  |  |  |  |  |  | B11R00056 | Leverhulme-Lovett-09/14 | R65 | Research | 1276 | 2011-10-01 | 2014-09-30
 |  |  |  |  |  |  |  |  |  |  |  |  |  | B11R00057 | EC-SNaPy-Hadfield-09/13 | R35 | Research | 1276 | 2011-10-01 | 2013-09-30
 |  |  |  |  |  |  |  |  |  |  |  |  |  | B11R00058 | RS-Hadfield-9/14 | R27 | PI transfers out 31/12/12 | 1276 | 2011-10-01 | 2012-12-31
 |  |  |  |  |  |  |  |  |  |  |  |  |  | B11R00059 | EOARD-Kar-09/12 | R45 | Research | 1276 | 2011-10-01 | 2012-12-31
 |  |  |  |  |  |  |  |  |  |  |  |  |  | B11R00060 | Teknova-Richards-04/15 | R80 | Research | 1276 | 2011-07-22 | 2015-04-02
 |  |  |  |  |  |  |  |  |  |  |  |  |  | B11R00061 | EPSRC-Hand-04/15 | R20 | Research | 1276 | 2011-10-01 | 2015-04-02
 |  |  |  |  |  |  |  |  |  |  |  |  |  | B11R00062 | SELEX Galileo-Hong-10/12 | R70 | Research | 1274 | 2011-10-10 | 2013-03-31
 |  |  |  |  |  |  |  |  |  |  |  |  |  | B11R00064 | SSE-Flynn-04/15 | R70 | Research | 1274 | 2011-11-01 | 2015-04-30
 |  |  |  |  |  |  |  |  |  |  |  |  |  | B11R00065 | EPSRC-Mallick-04/15 | R20 | Research | 1278 | 2011-11-01 | 2015-04-30
 |  |  |  |  |  |  |  |  |  |  |  |  |  | B11R00066 | Renishaw-Lu-12/14 | R70 | Research | 1272 | 2011-11-01 | 2014-12-31
 |  |  |  |  |  |  |  |  |  |  |  |  |  | B11R00067 | SU2P(Strathclyde)-Reid-12/12 | R20 | Research | 1276 | 2011-11-16 | 2013-04-30
 |  |  |  |  |  |  |  |  |  |  |  |  |  | B11R00068 | Vattenfall-Fruh-05/12 | R75 | Research | 1278 | 2011-12-01 | 2013-01-16
 |  |  |  |  |  |  |  |  |  |  |  |  |  | B11R00071 | AWE-Reid-03/13 | R70 | Research | 1276 | 2011-01-01 | 2013-03-31
 |  |  |  |  |  |  |  |  |  |  |  |  |  | B11R00089 | TMVSE-Belyaev-7/16 | R70 | Research | 1274 | 2011-08-01 | 2016-07-31
 |  |  |  |  |  |  |  |  |  |  |  |  |  | B11R00090 | EPSRC(Strath)-CIM-Ni-09/16 | R20 | Research | 1278 | 2011-10-01 | 2016-09-30
 |  |  |  |  |  |  |  |  |  |  |  |  |  | B11R00092 | EPSRC-MacGregor-03/16 | R20 | Research | 1270 | 2012-09-01 | 2016-03-02
 |  |  |  |  |  |  |  |  |  |  |  |  |  | B11R00106 | TSB (Macphie)-Torres-05/14 | R30 | Research | 1272 | 2012-06-01 | 2014-05-31
 |  |  |  |  |  |  |  |  |  |  |  |  |  | B11R00109 | SSE(SHEPD)-Flynn-04/13 | R70 | Research | 1274 | 2012-01-01 | 2013-04-01
 |  |  |  |  |  |  |  |  |  |  |  |  |  | B11R00110 | H3G-Wang-02/15 | R70 | Research | 1274 | 2012-03-01 | 2015-02-28
 |  |  |  |  |  |  |  |  |  |  |  |  |  | B11R00116 | Nextek-Ocone-06/15 | R70 | Research | 1278 | 2012-01-01 | 2015-06-30
 |  |  |  |  |  |  |  |  |  |  |  |  |  | B11R00117 | EC*-PANDORA-Lane-12/14 | R35 | Project for Euro Receipts only | 1274 | 2012-01-01 | 2014-12-31
 |  |  |  |  |  |  |  |  |  |  |  |  |  | B11R00118 | EC-Pandora-Lane-12/14 | R35 | Research | 1274 | 2012-01-01 | 2014-12-31
 |  |  |  |  |  |  |  |  |  |  |  |  |  | B11R00119 | EPSRC Equip - Faccio - 12/14 | R20 | Research | 1276 | 2012-01-01 | 2014-12-31
 |  |  |  |  |  |  |  |  |  |  |  |  |  | B11R00121 | EPSRC-Faccio-12/14 | R20 | Research | 1276 | 2012-01-01 | 2014-12-31
 |  |  |  |  |  |  |  |  |  |  |  |  |  | B11R00124 | EPSRC(Sheffield)-Hadfield-1/17 | R20 | PI transfers out 31/12/12 | 1276 | 2012-01-16 | 2012-12-31
 |  |  |  |  |  |  |  |  |  |  |  |  |  | B11R00125 | MoD(BAE)-Lane-04/13 | R30 | Research | 1274 | 2012-02-22 | 2013-04-21
 |  |  |  |  |  |  |  |  |  |  |  |  |  | B11R00131 | EPSRC-MacGregor-2/15 | R20 | Research | 1270 | 2012-03-01 | 2015-02-28
 |  |  |  |  |  |  |  |  |  |  |  |  |  | B11R00132 | EPSRC-Lane-2/15 | R20 | Research | 1274 | 2012-03-01 | 2015-07-15
 |  |  |  |  |  |  |  |  |  |  |  |  |  | B11R00135 | DSTL-Lane-2/16 | R30 | Research | 1274 | 2012-03-01 | 2016-02-28
 |  |  |  |  |  |  |  |  |  |  |  |  |  | B11R00136 | EPSRC-Maniscalco-05/13 | R20 | Research | 1276 | 2012-06-01 | 2013-07-31
 |  |  |  |  |  |  |  |  |  |  |  |  |  | B11R00137 | FMCTI-Flynn-10/12 | R30 | Research | 1274 | 2012-03-14 | 2012-11-01
 |  |  |  |  |  |  |  |  |  |  |  |  |  | B11R00141 | M Solv-Shephard-03/16 | R70 | Research | 1276 | 2012-03-26 | 2017-03-25
 |  |  |  |  |  |  |  |  |  |  |  |  |  | B11R00143 | Alphasense(MU)-MacPherson-8/12 | R70 | Research | 1276 | 2012-03-01 | 2012-11-27
 |  |  |  |  |  |  |  |  |  |  |  |  |  | B11R00144 | EC-Arrows-Lane-08/15 | R35 | Research | 1274 | 2012-09-01 | 2015-08-31
 |  |  |  |  |  |  |  |  |  |  |  |  |  | B11R00145 | EPSRC (AS)-DESMULLIEZ-09/12 | R20 | Research | 1274 | 2012-04-01 | 2012-09-30
 |  |  |  |  |  |  |  |  |  |  |  |  |  | B11R00146 | EPSRC (AS)-GALBRAITH-09/12 | R20 | Research | 1276 | 2012-04-01 | 2012-10-31
 |  |  |  |  |  |  |  |  |  |  |  |  |  | B11R00147 | Dstl-Maier-8/12 | R30 | Research | 1276 | 2012-03-01 | 2012-11-30
 |  |  |  |  |  |  |  |  |  |  |  |  |  | B11R00148 | EPSRC (AS)-Duncan-03/13 | R20 | Research | 1272 | 2012-04-01 | 2013-03-31
 |  |  |  |  |  |  |  |  |  |  |  |  |  | B11R00150 | STFC-O'Donovan-04/13 | R26 | Research | 1278 | 2012-04-02 | 2013-04-01
 |  |  |  |  |  |  |  |  |  |  |  |  |  | B11R00151 | RS-Paterson-7/14 | R27 | Research | 1272 | 2012-08-01 | 2014-07-31
 |  |  |  |  |  |  |  |  |  |  |  |  |  | B11R00152 | RS-Thomson-3/13 | R27 | Research | 1276 | 2012-04-01 | 2013-03-31
 |  |  |  |  |  |  |  |  |  |  |  |  |  | B11R00153 | EPSRC(IS)-Bookey-01/13 | R20 | Research | 1276 | 2012-04-02 | 2013-01-18
 |  |  |  |  |  |  |  |  |  |  |  |  |  | B11R00154 | Huawei Tech-Hong-01/13 | R75 | Research | 1274 | 2012-05-15 | 2013-01-14
 |  |  |  |  |  |  |  |  |  |  |  |  |  | B11R00159 | EPSRC (AS)-Torres-03/13 | R20 | Research | 1272 | 2012-05-01 | 2013-03-01
 |  |  |  |  |  |  |  |  |  |  |  |  |  | B11R00160 | EPSRC-IMRC-HAND-03/13 | R20 | Research | 1276 | 2012-05-01 | 2013-03-31
 |  |  |  |  |  |  |  |  |  |  |  |  |  | B11R00165 | DSTL(via Imperial)-Clark-03/13 | R30 | Research | 1274 | 2012-07-31 | 2013-03-31
 |  |  |  |  |  |  |  |  |  |  |  |  |  | B11R00166 | EPSRC-Costen-3/16 | R20 | Research | 1270 | 2012-08-06 | 2016-08-05
 |  |  |  |  |  |  |  |  |  |  |  |  |  | B11R00167 | Selex Galileo-Record-12/12 | R70 | Research | 1274 | 2012-05-21 | 2012-12-31
 |  |  |  |  |  |  |  |  |  |  |  |  |  | B11R00168 | MoD-O'Donovan-09/12 | R30 | Research | 1278 | 2012-02-17 | 2012-10-31
 |  |  |  |  |  |  |  |  |  |  |  |  |  | B11R00176 | DRDC-Petillot-03/13 | R45 | Research | 1274 | 2012-06-08 | 2013-03-31
 |  |  |  |  |  |  |  |  |  |  |  |  |  | B11R00177 | Renishaw-Paterson-07/15 | R70 | Research | 1272 | 2012-08-01 | 2015-07-31
 |  |  |  |  |  |  |  |  |  |  |  |  |  | B11R00182 | EPSRC-Hadfield-04/15 | R20 | Research | 1276 | 2012-06-01 | 2016-05-31
 |  |  |  |  |  |  |  |  |  |  |  |  |  | B11R00185 | MOD(Seebyte)-Petillot-12/12 | R30 | Research | 1274 | 2012-07-05 | 2013-01-07
 |  |  |  |  |  |  |  |  |  |  |  |  |  | B11R00187 | Selex-Buller-11/15 | R70 | Research | 1276 | 2011-11-21 | 2016-11-20
 |  |  |  |  |  |  |  |  |  |  |  |  |  | B11R00189 | TMVSE-Belyaev-10/16 | R70 | Research | 1274 | 2011-10-03 | 2016-10-02
 |  |  |  |  |  |  |  |  |  |  |  |  |  | B11R00190 | EPSRC-Galbraith-06/15 | R20 | Research | 1276 | 2012-07-01 | 2015-06-30
 |  |  |  |  |  |  |  |  |  |  |  |  |  | B11R00193 | CDE (BAE)-Clark-03/13 | R30 | Research | 1274 | 2012-08-01 | 2013-03-15
 |  |  |  |  |  |  |  |  |  |  |  |  |  | B11R00194 | EPSRC (IS)-Faccio-03/13 | R20 | Research | 1276 | 2012-08-01 | 2013-03-31
 |  |  |  |  |  |  |  |  |  |  |  |  |  | B11R00197 | STFC-Thomson-07/14 | R26 | Research | 1276 | 2012-08-01 | 2014-07-31
 |  |  |  |  |  |  |  |  |  |  |  |  |  | B11R00198 | Leverhulme-Bos-08/15 | R65 | Research | 1270 | 2012-09-01 | 2015-08-31
 |  |  |  |  |  |  |  |  |  |  |  |  |  | B11R00204 | EPSRC-Welch-02/16 | R20 | Research | 1270 | 2012-09-01 | 2016-02-29
 |  |  |  |  |  |  |  |  |  |  |  |  |  | B11R00206 | Total-White-03/13 | R75 | Research | 1278 | 2012-04-01 | 2013-03-31
 |  |  |  |  |  |  |  |  |  |  |  |  |  | B11R00213 | EPSRC-Macgregor-08/15 | R20 | Research | 1270 | 2012-08-27 | 2015-08-26
 |  |  |  |  |  |  |  |  |  |  |  |  |  | B11R00226 | RS-Richards-09/13 | R27 | Research | 1276 | 2012-10-01 | 2013-09-30
 |  |  |  |  |  |  |  |  |  |  |  |  |  | B11R00231 | AWE-Moore-03/15 | R70 | Research | 1276 | 2011-12-01 | 2015-03-31
 |  |  |  |  |  |  |  |  |  |  |  |  |  | B11R00235 | SE-poc-(Strath)-Adams-01/14 | R30 | Research | 1270 | 2012-08-01 | 2014-01-31
 |  |  |  |  |  |  |  |  |  |  |  |  |  | B11R00242 | Carnegie-Richards-03/14 | R65 | Research | 1276 | 2012-10-01 | 2014-03-31
 |  |  |  |  |  |  |  |  |  |  |  |  |  | B11R00243 | EPSRC-IMRC-Ritchie-03/13 | R20 | Research | 1278 | 2012-03-01 | 2013-03-31
 |  |  |  |  |  |  |  |  |  |  |  |  |  | B11R00244 | FMC Tech-Flynn-06/15 | R70 | Research | 1274 | 2012-01-01 | 2015-06-30
 |  |  |  |  |  |  |  |  |  |  |  |  |  | B11R00247 | RS-RICHARDS-09/15 | R27 | Research | 1276 | 2012-10-01 | 2015-09-30
 |  |  |  |  |  |  |  |  |  |  |  |  |  | B11R00249 | RSE-Greenaway-05/14 | R27 | Research | 1272 | 2012-05-01 | 2014-05-31
 |  |  |  |  |  |  |  |  |  |  |  |  |  | B11R00250 | EPSRC-McLaughlin-09/13 | R20 | Research | 1274 | 2011-10-01 | 2013-09-30
 |  |  |  |  |  |  |  |  |  |  |  |  |  | B11R00251 | EPSRC-McLaughlin-10/13 | R20 | Research | 1274 | 2011-10-01 | 2013-10-31
 |  |  |  |  |  |  |  |  |  |  |  |  |  | B11R00252 | STFC-Duncan-01/13 | R26 | Research | 1272 | 2012-02-01 | 2013-01-31
 |  |  |  |  |  |  |  |  |  |  |  |  |  | B11R00258 | DSTL(ICSTM)-Clark-07/12 | R30 | Research | 1274 | 2012-02-22 | 2012-10-31
 |  |  |  |  |  |  |  |  |  |  |  |  |  | B11R00264 | DSTL-Petillot-03/16 | R30 | Research | 1274 | 2012-03-15 | 2016-03-31
 |  |  |  |  |  |  |  |  |  |  |  |  |  | B11R00267 | Leverhulme-Ocone-10/15 | R65 | Research | 1278 | 2012-09-07 | 2015-10-14
 |  |  |  |  |  |  |  |  |  |  |  |  |  | B11R00268 | RS-Lee-06/14 | R27 | Research | 1270 | 2012-06-30 | 2014-06-29
 |  |  |  |  |  |  |  |  |  |  |  |  |  | B11R00269 | EPSRC-McLaughlin-05/16 | R20 | Research | 1274 | 2012-06-01 | 2016-05-31
 |  |  |  |  |  |  |  |  |  |  |  |  |  | B11R00274 | EC-Sequoia-Gerardot-12/17 | R35 | Research | 1276 | 2013-01-01 | 2017-12-31
 |  |  |  |  |  |  |  |  |  |  |  |  |  | B11R00275 | EC-MOLIGHT-Faccio-10/17 | R35 | Expenditure bearing project | 1276 | 2012-11-01 | 2017-10-31
 |  |  |  |  |  |  |  |  |  |  |  |  |  | B11R00297 | EPSRC-Andersson-09/14 | R20 | Research | 1276 | 2013-04-01 | 2014-09-30
 |  |  |  |  |  |  |  |  |  |  |  |  |  | B11R00305 | STFC-Desmulliez-05/15 | R26 | Research | 1274 | 2011-06-01 | 2015-05-31
 |  |  |  |  |  |  |  |  |  |  |  |  |  | B11R00306 | DARPA(UCL)-Lovett-12/12 | R45 | Research | 1276 | 2011-06-16 | 2012-12-31
 |  |  |  |  |  |  |  |  |  |  |  |  |  | B11R00307 | DRDC-Lane-03/13 | R45 | Research | 1274 | 2011-07-20 | 2013-03-31
 |  |  |  |  |  |  |  |  |  |  |  |  |  | B11R00308 | EPSRC-Paterson M-10/15 | R20 | Research | 1270 | 2012-10-01 | 2015-09-30
 |  |  |  |  |  |  |  |  |  |  |  |  |  | B11R00309 | EPSRC(Warwick)-Upadhayaya-3/13 | R20 | Research | 1278 | 2011-10-01 | 2013-03-31
 |  |  |  |  |  |  |  |  |  |  |  |  |  | B11R00310 | AE-Petillot-12/12 | R70 | Research | 1274 | 2011-11-01 | 2012-12-31
 |  |  |  |  |  |  |  |  |  |  |  |  |  | B11R00311 | Atlas Elektronik-Brown-01/13 | R70 | Research | 1274 | 2011-11-01 | 2013-01-31
 |  |  |  |  |  |  |  |  |  |  |  |  |  | B11R00312 | EPSRC-IMRC2-Moore-3/13 | R20 | Research | 1276 | 2011-12-01 | 2013-03-31
 |  |  |  |  |  |  |  |  |  |  |  |  |  | B11R00323 | HW-EPSRC-Flynn-12/12 | R20 | Research | 1274 | 2012-06-01 | 2012-12-01
 |  |  |  |  |  |  |  |  |  |  |  |  |  | B11R10004 | Mitsubishi-Reay-01/13 | R70 | Research | 1278 | 2012-08-01 | 2013-01-31
 |  |  |  |  |  |  |  |  |  |  |  |  |  | B11S00001 | SFC(UoG)-Willoughby-06/16 | R60 | SRDG | 1272 | 2011-02-23 | 2016-06-30
 |  |  |  |  |  |  |  |  |  |  |  |  |  | B11S00002 | ETP-Mallick 10/14 | R60 | SRDG | 1278 | 2011-05-01 | 2014-10-31
 |  |  |  |  |  |  |  |  |  |  |  |  |  | B11S00003 | SFC-Willoughby-07/14 | R60 | SRDG | 1272 | 2011-04-28 | 2014-07-31
 |  |  |  |  |  |  |  |  |  |  |  |  |  | B11S00004 | ETP-Vaquiero-02/15 | R60 | SRDG | 1270 | 2011-09-01 | 2015-02-28
 |  |  |  |  |  |  |  |  |  |  |  |  |  | B11S00005 | ETP-Richards-03/15 | R60 | SRDG | 1276 | 2011-10-01 | 2015-03-31
 |  |  |  |  |  |  |  |  |  |  |  |  |  | B11S00006 | ETP-Richards-04/15 | R60 | SRDG | 1276 | 2011-07-22 | 2015-04-02
 |  |  |  |  |  |  |  |  |  |  |  |  |  | B11S00007 | ETP-Flynn-04/15 | R60 | SRDG | 1274 | 2011-11-01 | 2015-04-30
 |  |  |  |  |  |  |  |  |  |  |  |  |  | B11S00008 | SFC-Horizon-Dunnigan-03/14 | R60 | SRDG | 1274 | 2011-08-01 | 2014-07-31
 |  |  |  |  |  |  |  |  |  |  |  |  |  | B11S00009 | ETP-Ocone-06/15 | R60 | SRDG | 1278 | 2012-01-01 | 2015-06-30
 |  |  |  |  |  |  |  |  |  |  |  |  |  | B12N10109 | Crucible -Robertson-05/13 | O10 | Non Research | 1274 | 2012-07-02 | 2013-05-02
 |  |  |  |  |  |  |  |  |  |  |  |  |  | B12R10017 | Thales-Robertson-09/16 | R70 | Research | 1274 | 2012-09-03 | 2016-09-02
 |  |  |  |  |  |  |  |  |  |  |  |  |  | B12R10018 | Seebyte-Petillot-09/16 | R70 | Research | 1274 | 2012-09-10 | 2016-09-09
 |  |  |  |  |  |  |  |  |  |  |  |  |  | B12R10024 | EC-Powell-12/14 | R35 | Research | 1270 | 2012-09-01 | 2014-12-31
 |  |  |  |  |  |  |  |  |  |  |  |  |  | B12R10025 | EPSRC-Maroto Valer-02/18 | R20 | Research | 1278 | 2013-03-01 | 2018-02-28
 |  |  |  |  |  |  |  |  |  |  |  |  |  | B12R10027 | SELEX(Strathclyde)-Kar-11/12 | R70 | Research | 1276 | 2012-09-01 | 2012-12-31
 |  |  |  |  |  |  |  |  |  |  |  |  |  | B12R10037 | Renishaw-Yurchenko-12/12 | R70 | Research | 1278 | 2012-08-01 | 2013-01-31
 |  |  |  |  |  |  |  |  |  |  |  |  |  | B12R10039 | STFC-Thomson-09/17 | R26 | Research | 1276 | 2012-09-03 | 2016-09-02
 |  |  |  |  |  |  |  |  |  |  |  |  |  | B12R10051 | EC-Markx-07/16 | R35 | Linked to SLS project A11R00064 | 1272 | 2012-08-01 | 2016-12-31
 |  |  |  |  |  |  |  |  |  |  |  |  |  | B12R10057 | EPSRC (IS) - Shu - 3/13 | R20 | Research | 1272 | 2012-07-01 | 2013-03-31
 |  |  |  |  |  |  |  |  |  |  |  |  |  | B12R10058 | Renishaw-Hand-10/14 | R70 | Research | 1276 | 2010-09-13 | 2015-09-12
 |  |  |  |  |  |  |  |  |  |  |  |  |  | B12R10059 | SPI Lasers-Hand-03/16 | R70 | Research | 1276 | 2012-10-01 | 2016-03-31
 |  |  |  |  |  |  |  |  |  |  |  |  |  | B12R10079 | BC UKIERI-Sellathurai-12/14 | R30 | Research | 1274 | 2012-10-01 | 2014-12-31
 |  |  |  |  |  |  |  |  |  |  |  |  |  | B12R10080 | DSTL(ICL)-SELLATHURAI-03/13 | R30 | Research | 1274 | 2012-09-01 | 2013-03-01
 |  |  |  |  |  |  |  |  |  |  |  |  |  | B12R10089 | EPSRC-IS-Thomson-12/12 | R20 | Research | 1276 | 2012-06-01 | 2012-12-31
 |  |  |  |  |  |  |  |  |  |  |  |  |  | B12R10090 | EPSRC-Upadhyaya-30/09/13 | R20 | Research | 1278 | 2011-10-01 | 2013-10-02
 |  |  |  |  |  |  |  |  |  |  |  |  |  | B12R10095 | DSTL-Sellathurai-10/16 | R30 | Research | 1274 | 2012-10-08 | 2016-10-07
 |  |  |  |  |  |  |  |  |  |  |  |  |  | B12R10096 | AE-Reid-12/12 | R70 | Research | 1276 | 2012-11-01 | 2012-12-31
 |  |  |  |  |  |  |  |  |  |  |  |  |  | B12R10101 | EC*-MOLIGHT-Faccio-10/17 | R35 | Research | 1276 | 2012-11-01 | 2017-10-31
 |  |  |  |  |  |  |  |  |  |  |  |  |  | B12R10113 | EPSRC-Lee-03/13 | R20 | Research | 1278 | 2012-11-01 | 2013-03-31
 |  |  |  |  |  |  |  |  |  |  |  |  |  | B12R10114 | EPSRC-Rickman-03/13 | R20 | Research | 1272 | 2012-11-01 | 2013-03-31
 |  |  |  |  |  |  |  |  |  |  |  |  |  | B12R10115 | EPSRC-Faccio-03/13 | R20 | Research | 1276 | 2012-11-01 | 2013-03-31
 |  |  |  |  |  |  |  |  |  |  |  |  |  | B12R10116 | EPSRC-MacGregor-03/13 | R20 | Research | 1270 | 2012-11-01 | 2013-03-31
 |  |  |  |  |  |  |  |  |  |  |  |  |  | B12R10117 | EPSRC-Flynn-03/13 | R20 | Research | 1274 | 2012-11-01 | 2013-03-31
 |  |  |  |  |  |  |  |  |  |  |  |  |  | B12R10153 | EC*-SEQUoiA-Gerardot-12/17 | R35 | EURO RECEIPTS PROJECT ONLY | 1276 | 2013-01-01 | 2017-12-31
 |  |  |  |  |  |  |  |  |  |  |  |  |  | B11R00205 | EPSRC(UoE)-Yiu-08/15 | R20 | Research | 1270 | 2012-09-01 | 2015-08-31
 |  |  |  |  |  |  |  |  |  |  |  |  |  | B12R10071 | MerlinCircuit-Desmulliez-09/16 | R70 | Research | 1274 | 2012-09-10 | 2016-09-09
 |  |  |  |  |  |  |  |  |  |  |  |  |  | B11R00207 | RSE-Ocone-10/12 | R27 | Research | 1278 | 2012-10-01 | 2012-10-31
 |  |  |  |  |  |  |  |  |  |  |  |  |  | B11R00321 | MRC-Duncan-12/17 | R24 | Research | 1272 | 2013-01-01 | 2017-12-31
 |  |  |  |  |  |  |  |  |  |  |  |  |  | B12R00152 | DSTL-Reid-06/13 | R30 | Research | 1276 | 2012-12-01 | 2013-06-30
 |  |  |  |  |  |  |  |  |  |  |  |  |  | B12R10021 | Renishaw Diag-Shu-11/12 | R70 | Research | 1272 | 2012-10-01 | 2013-03-31
 |  |  |  |  |  |  |  |  |  |  |  |  |  | B11R00241 | EPSRC-Buller-09/16 | R20 | Research | 1276 | 2013-01-01 | 2016-12-31
 |  |  |  |  |  |  |  |  |  |  |  |  |  | B12R10157 | Optoscribe-Kar-11/17 | R27 | Research | 1276 | 2013-02-12 | 2013-02-12
 |  |  |  |  |  |  |  |  |  |  |  |  |  | B12R10100 | RAE-Mateo-Segura-09/13 | R65 | Research | 1274 | 2013-03-15 | 2013-09-14
 |  |  |  |  |  |  |  |  |  |  |  |  |  | B12R10221 | RS-Nahler-09/15 | R27 | Research | 1270 | 2012-10-01 | 2015-09-30
 |  |  |  |  |  |  |  |  |  |  |  |  |  | B11R00281 |  | R20 | Research | 1274 | 2013-01-01 | 2016-12-31
 |  |  |  |  |  |  |  |  |  |  |  |  |  | B12S10223 |  | R60 | Research | 1270 | 2012-10-01 | 2014-03-31
 |  |  |  |  |  |  |  |  |  |  |  |  |  | B11R00171 | Robert Maier | R30 | Research | 1276 | 2013-02-01 | 2017-01-31
 |  |  |  |  |  |  |  |  |  |  |  |  |  | B12R10228 | Martin McCoustra | R20 | Research | 1270
 |  |  |  |  |  |  |  |  |  |  |  |  |  | B12R10195 | Robert Thomson | R70 | Research | 1276 | 2013-01-01 | 2016-08-01
 |  |  |  |  |  |  |  |  |  |  |  |  |  | B12R10104 | R OCCONE | R70 | Research | 1278 | 2013-01-03 | 2013-06-30
 |  |  |  |  |  |  |  |  |  |  |  |  |  | B12R10178 | M MARATO VALER | R20 | Research | 1278 | 2013-02-17 | 2013-09-16
 |  |  |  |  |  |  |  |  |  |  |  |  |  | B11R00184 | R THOMSON | R35 | Research | 1276 | 2013-01-01 | 2016-12-31
 |  |  |  |  |  |  |  |  |  |  |  |  |  | B12R10180 | VASSILLIS SBOROS | R24 | Research | 1272 | 2012-07-01 | 2013-07-31
 |  |  |  |  |  |  |  |  |  |  |  |  |  | B12R10165 | WILL SHU | R50 | Research | 1272 | 2013-01-01 | 2013-07-01
 |  |  |  |  |  |  |  |  |  |  |  |  |  | B11R00219 | AI-LAN LEE | R22 | Research | 1270 | 2013-03-11 | 2016-03-10
 |  |  |  |  |  |  |  |  |  |  |  |  |  | B12R10065 | DAVID FLYNN | R20 | Research | 1274 | 2013-02-01 | 2015-01-31
 |  |  |  |  |  |  |  |  |  |  |  |  |  | B12R10210 | RAFFAELLA OCONE | R12 | Research | 1278 | 2012-04-01 | 2015-03-31
 |  |  |  |  |  |  |  |  |  |  |  |  |  | B11R10010 | M MARATO VALER | R30 | Research | 1278
 |  |  |  |  |  |  |  |  |  |  |  |  |  | B13R10611 | M MARATO VALER | R30 | Research | 1278 | 2013-02-01 | 2014-03-31
 |  |  |  |  |  |  |  |  |  |  |  |  |  | B12R10212 | D REID | R70 | Research | 1276 | 2011-09-12 | 2016-09-11
 |  |  |  |  |  |  |  |  |  |  |  |  |  | B12R10213 | D REID | R70` | Research | 1276 | 2011-09-12 | 2016-09-11
 |  |  |  |  |  |  |  |  |  |  |  |  |  | B12R10249 | D REID | R20 | Research | 1276
 |  |  |  |  |  |  |  |  |  |  |  |  |  | B12R00186 | G LLOYD | R50 | Research | 1270 | 2013-01-03 | 2013-12-31
 |  |  |  |  |  |  |  |  |  |  |  |  |  | B12R10248 | B RICHARDS | R20 | Research | 1276
 |  |  |  |  |  |  |  |  |  |  |  |  |  | B12R10247 | D ADAMS | R20 | Research | 1270
 |  |  |  |  |  |  |  |  |  |  |  |  |  | B12R10164 | A KAR | R80 | Research | 1276 | 2012-12-31 | 2015-12-28
 |  |  |  |  |  |  |  |  |  |  |  |  |  | B12R10214 | B GERADOT | R70 | Research | 1276 | 2013-01-07 | 2018-01-06
 |  |  |  |  |  |  |  |  |  |  |  |  |  | B12R10248 | B RICHARDS | R20 | Research | 1276
 |  |  |  |  |  |  |  |  |  |  |  |  |  | B11R00229 | H BOOKEY | R30 | Research | 1276 | 2013-03-01 | 2015-02-28
 |  |  |  |  |  |  |  |  |  |  |  |  |  | B12R10266 | G BULLER | R20 | Research | 1276
 |  |  |  |  |  |  |  |  |  |  |  |  |  | B11R00262 | Pettilot | R20 | Research | 1274 | 2013-04-01 | 2018-03-31
 |  |  |  |  |  |  |  |  |  |  |  |  |  | B12R10191 | LOVETT | R45 | Research | 1276 | 2012-12-16 | 2014-06-15
 |  |  |  |  |  |  |  |  |  |  |  |  |  | B12R10216 | WANG | R12 | Research | 1276 | 2013-03-25 | 2013-06-21
 |  |  |  |  |  |  |  |  |  |  |  |  |  | B12R10288 | BRIDLE | R65 | Research | 1272 | 2012-09-10 | 2015-02-28
 |  |  |  |  |  |  |  |  |  |  |  |  |  | B12R10257 | R THOMSON | R26 | Research | 1276 | 2013-10-01 | 2018-09-30
 |  |  |  |  |  |  |  |  |  |  |  |  |  | B12R10030 | D TOWNSEND | R20 | Research | 1276 | 2013-06-01 | 2016-11-30
 |  |  |  |  |  |  |  |  |  |  |  |  |  | B12R10026 | M DESMULLIEZ | R20 | Research | 1274 | 2013-04-01 | 2014-09-30
 |  |  |  |  |  |  |  |  |  |  |  |  |  | B12R10111 | S MACGREGOR | R20 | Research | 1270 | 2013-05-01 | 2015-04-30
 |  |  |  |  |  |  |  |  |  |  |  |  |  | B12R10244 | M MAROTO-VALER | R65 | Research | 1278 | 2012-09-01 | 2013-09-30
 |  |  |  |  |  |  |  |  |  |  |  |  |  | B11R00158 | MAIWEEN KERSAUDY KERHOAS | R65 | Research | 1272 | 2013-01-07 | 2018-07-06
 |  |  |  |  |  |  |  |  |  |  |  |  |  | B12R10277 | B CHEN | R27 | Research | 1278 | 2013-05-01 | 2015-04-30
 |  |  |  |  |  |  |  |  |  |  |  |  |  | B12R10224 | KAR | R27 | Research | 1276 | 2013-09-01 | 2015-08-31
 |  |  |  |  |  |  |  |  |  |  |  |  |  | B11R00298 | McLaughlin | R20 | Research | 1274 | 2013-05-27 | 2018-05-26
 |  |  |  |  |  |  |  |  |  |  |  |  |  | B12R10055 | Petillot | R27 | Research | 1274 | 2013-05-01 | 2015-04-30
 |  |  |  |  |  |  |  |  |  |  |  |  |  | B12R10134 | BOS | R20 | Research | 1270 | 2013-04-01 | 2014-09-30
 |  |  |  |  |  |  |  |  |  |  |  |  |  | B12R10149 | R DUNCAN | R24 | Research | 1272 | 2013-05-25 | 2013-11-26
 |  |  |  |  |  |  |  |  |  |  |  |  |  | B12R10020 | RICKMAN | R24 | Research | 1272 | 2013-05-01 | 2016-04-30
 |  |  |  |  |  |  |  |  |  |  |  |  |  | B12R10106 | CHEN | R20 | Research | 1278
 |  |  |  |  |  |  |  |  |  |  |  |  |  | B12R10306 | SELLATHURAI | R20 | Research | 1274 | 2012-09-01 | 2015-05-31
 |  |  |  |  |  |  |  |  |  |  |  |  |  | B12R10043 | THOMSON | R26 | Research | 1276 | 2013-09-01 | 2015-08-31
 |  |  |  |  |  |  |  |  |  |  |  |  |  | B12R10066 | GREENAWAY | R21 | Research | 1272 | 2013-03-01 | 2014-07-31
 |  |  |  |  |  |  |  |  |  |  |  |  |  | B13R10367 | BRIDLE | R20 | Research | 1272
 |  |  |  |  |  |  |  |  |  |  |  |  |  | B13R10366 | LU | R20 | Research | 1272
 |  |  |  |  |  |  |  |  |  |  |  |  |  | B12N10202 | Richards | O10 | Non-research | 1276 | 2012-10-15 | 2015-10-14
 |  |  |  |  |  |  |  |  |  |  |  |  |  | B12R10311 | Leslie | R24 | Research | 1272 | 2013-01-01 | 2014-09-30
 |  |  |  |  |  |  |  |  |  |  |  |  |  | B12R10328 | Goussetis | R75 | Research | 1274 | 2013-03-01 | 2014-12-31
 |  |  |  |  |  |  |  |  |  |  |  |  |  | B12R10061 | Harper | R70 | Research | 1278 | 2012-11-01 | 2016-04-30
 |  |  |  |  |  |  |  |  |  |  |  |  |  | B13R10396 | Miller (Lane) | R20 | Research | 1274 | 2013-07-01 | 2014-09-30
 |  |  |  |  |  |  |  |  |  |  |  |  |  | B12R00250 | Jason Hong | R30 | Research | 1274 | 2013-08-01 | 2014-11-30
 |  |  |  |  |  |  |  |  |  |  |  |  |  | B12R10334 | Vassilis Sboros | R65 | Research | 1272 | 2013-06-01 | 2016-07-31
 |  |  |  |  |  |  |  |  |  |  |  |  |  | B12R10253 | G Goussetis | R75 | Research | 1274 | 2013-06-07 | 2014-11-06
 |  |  |  |  |  |  |  |  |  |  |  |  |  | B12R10064 | S McLaughlin | R20 | Research | 1274 | 2013-10-01 | 2015-09-30
 |  |  |  |  |  |  |  |  |  |  |  |  |  | B11R00291 | X Kong | R20 | Research | 1278 | 2013-07-01 | 2017-06-30
 |  |  |  |  |  |  |  |  |  |  |  |  |  | B12S10045 | A Harper | R70 | Research | 1278 | 2012-11-01 | 2016-04-30
 |  |  |  |  |  |  |  |  |  |  |  |  |  | B12R10194 | M Desmulliez | R65 | Research | 1274 | 2013-06-24 | 2014-06-30
 |  |  |  |  |  |  |  |  |  |  |  |  |  | B12R00325 | Nik Willoughby | R80 | Research | 1272 | 2013-06-16 | 2015-03-15
 |  |  |  |  |  |  |  |  |  |  |  |  |  | B12N10301 | Will Shu | O12 | Non-research | 1270 | 2013-11-01 | 2016-04-30
 |  |  |  |  |  |  |  |  |  |  |  |  |  | B12R10082 | K McKendrick | R20 | Research | 1270 | 2013-09-25 | 2016-09-24
 |  |  |  |  |  |  |  |  |  |  |  |  |  | B12R10295 | K Prior | R50 | Research | 1276 | 2013-09-06 | 2014-07-31
 |  |  |  |  |  |  |  |  |  |  |  |  |  | B12R10038 | B Richards | R20 | Research | 1276 | 2013-11-01 | 2017-10-31
 |  |  |  |  |  |  |  |  |  |  |  |  |  | B13R10359 | H Baker | R70 | Research | 1278 | 2013-08-01 | 2014-01-31
 |  |  |  |  |  |  |  |  |  |  |  |  |  | B12R10300 | A Moore | R70 | Research | 1276 | 2013-09-09 | 2017-05-15
 |  |  |  |  |  |  |  |  |  |  |  |  |  | B12R10242 | X Wang | R50 | Research | 1276 | 2013-05-20 | 2013-11-19
 |  |  |  |  |  |  |  |  |  |  |  |  |  | B12R10299 | Paul Dalgarno | R26 | Research | 1272 | 2013-09-09 | 2013-09-08
 |  |  |  |  |  |  |  |  |  |  |  |  |  | B11R00177 | W MacPherson | R70 | Research | 1272 | 2012-08-01 | 2015-07-31
 |  |  |  |  |  |  |  |  |  |  |  |  |  | B12R00220 | M Dunnigan | R70 | Research | 1274 | 2013-08-12 | 2017-02-11
 |  |  |  |  |  |  |  |  |  |  |  |  |  | B12R10263 | Flynn | R70 | Research | 1274 | 2013-04-01 | 2014-01-31
 |  |  |  |  |  |  |  |  |  |  |  |  |  | B13R10398 | Flynn | R70 | Research | 1274 | 2013-10-01 | 2017-03-31
 |  |  |  |  |  |  |  |  |  |  |  |  |  | B12R10231 | X Ni | R20 | Research | 1278 | 2013-10-01 | 2017-09-30
 |  |  |  |  |  |  |  |  |  |  |  |  |  | B12S10307 | Flynn | R60 | Research | 1274 | 2013-10-01 | 2017-03-31
 |  |  |  |  |  |  |  |  |  |  |  |  |  | B12R10302 | R DUNCAN | R35 | Research | 1272 | 2014-01-01 | 2016-12-31
 |  |  |  |  |  |  |  |  |  |  |  |  |  | B12R10219 | Wang Cheng-Xiang | R80 | Research | 1274 | 2013-09-11 | 2015-03-10
 |  |  |  |  |  |  |  |  |  |  |  |  |  | B13R00398 | Flynn | R70 | Research | 1274 | 2013-10-01 | 2017-03-31
 |  |  |  |  |  |  |  |  |  |  |  |  |  | B13R10405 | Goussetis | R75 | Research | 1274 | 2013-12-05 | 2014-06-16
 |  |  |  |  |  |  |  |  |  |  |  |  |  | B11R00314 | Desmulliez | R20 | Research | 1274 | 2013-05-27 | 2018-05-26
 |  |  |  |  |  |  |  |  |  |  |  |  |  | B12R00220 | M Dunnigan | R60 | Research | 1274 | 2013-08-12 | 2017-02-11
 |  |  |  |  |  |  |  |  |  |  |  |  |  | B12R10343 | X Ni | R70 | Research | 1276 | 2013-08-01 | 2015-10-31
 |  |  |  |  |  |  |  |  |  |  |  |  |  | B13R10433 | Hand | R20 | Research | 1276 | 2013-10-01 | 2015-09-30
 |  |  |  |  |  |  |  |  |  |  |  |  |  | B13R10425 | Esser | R20 | Research | 1276 | 2013-09-23 | 2018-09-22
 |  |  |  |  |  |  |  |  |  |  |  |  |  | B13R10423 | Reid | R70 | Research | 1276 | 2013-10-01 | 2018-09-30
 |  |  |  |  |  |  |  |  |  |  |  |  |  | B13R10430 | Esser | R20 | Research | 1276 | 2013-11-01 | 2016-01-07
 |  |  |  |  |  |  |  |  |  |  |  |  |  | B12R10188 | Maroto-Valer | R35 | Research | 1278 | 2014-01-01 | 2014-12-31
 |  |  |  |  |  |  |  |  |  |  |  |  |  | B13R10365 | Reid | R20 | Research | 1276 | 2013-09-09 | 2017-10-01
 |  |  |  |  |  |  |  |  |  |  |  |  |  | B13N10369 | Flynn | O12 | Non-research | 1274 | 2013-11-01 | 2016-07-31
 |  |  |  |  |  |  |  |  |  |  |  |  |  | B12R10124 | Maroto-Valer | R20 | Research | 1278 | 2013-11-01 | 2017-02-28
 |  |  |  |  |  |  |  |  |  |  |  |  |  | B12R10411 | Desmulliez | R20 | Research | 1274 | 2014-02-01 | 2015-07-31
 |  |  |  |  |  |  |  |  |  |  |  |  |  | B13S10363 | Willoughby | R60 | Research | 1272 | 2013-12-15 | 2014-06-15
 |  |  |  |  |  |  |  |  |  |  |  |  |  | B13R10346 | Shephard | R20 | Research | 1276 | 2014-03-03 | 2016-03-02
 |  |  |  |  |  |  |  |  |  |  |  |  |  | B12R10175 | Goussetis | R35 | Research | 1274 | 2014-01-01 | 2017-12-31
 |  |  |  |  |  |  |  |  |  |  |  |  |  | B13R10416 | Raey | R65 | Research | 1274 | 2014-01-01 | 2014-07-14
 |  |  |  |  |  |  |  |  |  |  |  |  |  | B13R10413 | Willoughby | R20 | Research | 1272 | 2014-03-02 | 2015-09-01
 |  |  |  |  |  |  |  |  |  |  |  |  |  | B13R10454 | Prior | R50 | Research | 1276 | 2014-01-06 | 2014-07-06
 |  |  |  |  |  |  |  |  |  |  |  |  |  | B13R10434 | RICKMAN | R65 | Research | 1272 | 2014-02-01 | 2014-10-31
 |  |  |  |  |  |  |  |  |  |  |  |  |  | B13R10424 | Bennett | R27 | Research | 1276 | 2014-03-01 | 2016-02-29
 |  |  |  |  |  |  |  |  |  |  |  |  |  | B12R10317 | Reid | R30 | Research | 1276 | 2014-01-01 | 2014-08-31
 |  |  |  |  |  |  |  |  |  |  |  |  |  | B13R10513 | Leach |  | Research | 1276 | 2014-02-01 | 2014-09-01
 |  |  |  |  |  |  |  |  |  |  |  |  |  | B13R10543 | Kersaudy-Kerhoas | R20 | Research | 1272 | 2014-05-01 | 2015-05-01
 |  |  |  |  |  |  |  |  |  |  |  |  |  | B13R10480 | Hartmann | R75 | Research | 1276 | 2014-02-01 | 2015-01-31
 |  |  |  |  |  |  |  |  |  |  |  |  |  | B11R00120 | Lane | R35 | Research | 1274 | 2014-01-01 | 2017-12-31
 |  |  |  |  |  |  |  |  |  |  |  |  |  | B13R10414 | Ocone | R65 | Research | 1278 | 2014-06-01 | 2014-11-30
 |  |  |  |  |  |  |  |  |  |  |  |  |  | B13R10418 | Yiu | R27 | Research | 1270 | 2014-03-31 | 2015-03-30
 |  |  |  |  |  |  |  |  |  |  |  |  |  | B12R10318 | Swingler | R70 | Research | 1276 | 2014-03-20 | 2017-03-19
 |  |  |  |  |  |  |  |  |  |  |  |  |  | B13R10472 | Maier | R12 | Research | 1276 | 2014-02-01 | 2014-09-30
 |  |  |  |  |  |  |  |  |  |  |  |  |  | B13R10476 | Hand | R12 | Research | 1276 | 2014-04-01 | 2015-03-31
 |  |  |  |  |  |  |  |  |  |  |  |  |  | B13R10507 | Taghizadeh | R70 | Research | 1276 | 2014-06-01 | 2018-02-28
 |  |  |  |  |  |  |  |  |  |  |  |  |  | B13R10439 | MacPherson | R70 | Research | 1276 | 2014-05-01 | 2014-12-31
 |  |  |  |  |  |  |  |  |  |  |  |  |  | B13R10559 | Reid | R50 | Research | 1276 | 2014-05-21 | 2014-06-20
 |  |  |  |  |  |  |  |  |  |  |  |  |  | B12R10322 | Bridle | R30 | Research | 1272 | 2014-03-01 | 2016-02-28
 |  |  |  |  |  |  |  |  |  |  |  |  |  | B13R10427 | Wang Cheng-Xiang | R80 | Research | 1274 | 2014-03-11 | 2015-03-10
 |  |  |  |  |  |  |  |  |  |  |  |  |  | B12R10312 | Upadhyaya | R30 | Research | 1278 | 2014-03-01 | 2016-02-28
 |  |  |  |  |  |  |  |  |  |  |  |  |  | B13R10455 | Desmulliez | R20 | Research | 1274 | 2014-03-07 | 2015-02-28
 |  |  |  |  |  |  |  |  |  |  |  |  |  | B12R10192 | Taghizadeh | R70 | Research | 1276 | 2013-05-01 | 2014-05-31
 |  |  |  |  |  |  |  |  |  |  |  |  |  | B12R10190 | Wang | R35 | Research | 1274 | 2014-07-01 | 2018-06-30
 |  |  |  |  |  |  |  |  |  |  |  |  |  | B13R10527 | O'Donovan | R24 | Research | 1278 | 2014-03-01 | 2014-11-30
 |  |  |  |  |  |  |  |  |  |  |  |  |  | B13R10514 | Kar | R70 | Research | 1276 | 2014-03-07 | 2019-03-06
 |  |  |  |  |  |  |  |  |  |  |  |  |  | B13R10381 | Prior | R20 | Research | 1276 | 2014-07-01 | 2017-12-31
 |  |  |  |  |  |  |  |  |  |  |  |  |  | B13R10632 | Buller | R20 | Research | 1276 | 2014-05-01 | 2015-03-31
 |  |  |  |  |  |  |  |  |  |  |  |  |  | B13R10361 | Faccio | R35 | Research | 1276 | 2014-07-01 | 2016-06-30
 |  |  |  |  |  |  |  |  |  |  |  |  |  | B12D10272 | Lane | R20 | Research | 1274 | 2014-04-01 | 2022-09-30
 |  |  |  |  |  |  |  |  |  |  |  |  |  | B13R10546 | Duncan | R65 | Research | 1272 | 2014-08-01 | 2015-07-31
 |  |  |  |  |  |  |  |  |  |  |  |  |  | B13R10563 | Yurchenko | R70 | Research | 1278 | 2014-08-15 | 2014-12-15
 |  |  |  |  |  |  |  |  |  |  |  |  |  | B13R10530 | Shu | R20 | Research | 1272 | 2014-08-01 | 2016-01-31
 |  |  |  |  |  |  |  |  |  |  |  |  |  | B13R10547 | Maroto-Valer | R20 | Research | 1278 | 2014-09-01 | 2016-03-01
 |  |  |  |  |  |  |  |  |  |  |  |  |  | B13R10642 | Desmulliez | R70 | Research | 1274 | 2014-09-01 | 2018-08-31
 |  |  |  |  |  |  |  |  |  |  |  |  |  | B14R10650 | Subr | R27 | Research | 1274 | 2014-10-01 | 2019-09-30
 |  |  |  |  |  |  |  |  |  |  |  |  |  | B12R10344 | Shu | R65 | Research | 1272 | 2014-09-01 | 2018-08-31
 |  |  |  |  |  |  |  |  |  |  |  |  |  | B13R10501 | Mansell | R20 | Research | 1270 | 2014-09-17 | 2015-10-05
 |  |  |  |  |  |  |  |  |  |  |  |  |  | B13R10506 | Lloyd | R27 | Research | 1270 | 2014-10-01 | 2019-09-30
 |  |  |  |  |  |  |  |  |  |  |  |  |  | B13R10458 | Petillot | R70 | Research | 1274 | 2014-01-01 | 2014-10-31
 |  |  |  |  |  |  |  |  |  |  |  |  |  | B13R10495 | Chen | R20 | Research | 1276 | 2014-09-01 | 2016-08-31
 |  |  |  |  |  |  |  |  |  |  |  |  |  | B14R10697 | Desmulliez | R20 | Research | 1274 | 2014-10-01 | 2015-03-31
 |  |  |  |  |  |  |  |  |  |  |  |  |  | B14R10690 | Nahler | R20 | Research | 1270 | 2014-09-01 | 2015-09-30
 |  |  |  |  |  |  |  |  |  |  |  |  |  | B13R10643 | Ni | R70 | Research | 1278 | 2014-08-01 | 2018-01-31
 |  |  |  |  |  |  |  |  |  |  |  |  |  | B14N10743 | Willoughby | O12 | Research | 1272 | 2014-04-22 | 2016-04-21
 |  |  |  |  |  |  |  |  |  |  |  |  |  | B13R10617 | Robertson | R70 | Research | 1274 | 2014-10-01 | 2018-03-31
 |  |  |  |  |  |  |  |  |  |  |  |  |  | B13R10510 | Saleh | R27 | Research | 1276 | 2014-10-01 | 2019-09-30
 |  |  |  |  |  |  |  |  |  |  |  |  |  | B13R10561 | Flynn | R20 | Research | 1274 | 2015-01-01 | 2015-08-31
 |  |  |  |  |  |  |  |  |  |  |  |  |  | B13R10499 | Gauger | R27 | Research | 1276 | 2014-10-01 | 2019-09-30
 |  |  |  |  |  |  |  |  |  |  |  |  |  | B13R10607 | Vilela | R27 | Research | 1270 | 2014-12-15 | 2015-12-14
 |  |  |  |  |  |  |  |  |  |  |  |  |  | B12D10338 | Macgregor | R55 | Research | 1270 | 2014-04-01 | 2022-09-30
 |  |  |  |  |  |  |  |  |  |  |  |  |  | B13R10639 | Willoughby | R30 | Research | 1272 | 2014-11-01 | 2016-10-31
 |  |  |  |  |  |  |  |  |  |  |  |  |  | B14R10734 | Esser | R27 | Research | 1276 | 2014-02-14 | 2019-02-13
 |  |  |  |  |  |  |  |  |  |  |  |  |  | B12R10083 | Maroto-Valer | R20 | Research | 1278 | 2014-05-13 | 2016-05-12
 |  |  |  |  |  |  |  |  |  |  |  |  |  | B13R10646 | Xuan | R80 | Research | 1278 | 2014-10-14 | 2015-10-13
 |  |  |  |  |  |  |  |  |  |  |  |  |  | B13R10620 | White | R75 | Research | 1278 | 2014-11-01 | 2015-06-30
 |  |  |  |  |  |  |  |  |  |  |  |  |  | B14R10667 | Upadhyaya | R20 | Research | 1278 | 2014-10-01 | 2014-10-31
 |  |  |  |  |  |  |  |  |  |  |  |  |  | B12R10251 | McLaughlin | R20 | Research | 1274 | 2014-08-11 | 2019-08-10
 |  |  |  |  |  |  |  |  |  |  |  |  |  | B14R10696 | Reid | R70 | Research | 1276 | 2014-06-09 | 2018-06-08
 |  |  |  |  |  |  |  |  |  |  |  |  |  | B12D10271 | Reid | R20 | Research | 1276 | 2014-09-01 | 2023-02-28
 |  |  |  |  |  |  |  |  |  |  |  |  |  | B13R10600 | Bock | R65 | Research | 1270 | 2014-10-20 | 2014-11-08
 |  |  |  |  |  |  |  |  |  |  |  |  |  | B13R10529 | Moore | R20 | Research | 1276 | 2014-08-01 | 2015-04-30
 |  |  |  |  |  |  |  |  |  |  |  |  |  | B14R10679 | Desmulliez | R70 | Research | 1274 | 2014-09-15 | 2018-08-14
 |  |  |  |  |  |  |  |  |  |  |  |  |  | B13R10623 | SELLATHURAI | R20 | Research | 1274 | 2015-01-15 | 2018-01-14
 |  |  |  |  |  |  |  |  |  |  |  |  |  | B13R10544 | Faccio | R20 | Research | 1276 | 2014-12-01 | 2017-11-30
 |  |  |  |  |  |  |  |  |  |  |  |  |  | B13R10468 | Hong | R75 | Research | 1274 | 2014-07-01 | 2016-06-30
 |  |  |  |  |  |  |  |  |  |  |  |  |  | B13R10461 | Yee | R20 | Research | 1278 | 2014-05-01 | 2015-04-30
 |  |  |  |  |  |  |  |  |  |  |  |  |  | B14D10752 | Ni | R55 | Research | 1278 | 2014-10-01 | 2018-09-30
 |  |  |  |  |  |  |  |  |  |  |  |  |  | B14D10751 | Ni | R55 | Research | 1278 | 2014-10-01 | 2018-09-30
 |  |  |  |  |  |  |  |  |  |  |  |  |  | B14D10761 | Ni | R55 | Research | 1278 | 2013-10-01 | 2016-09-30

Sheet: Coding Guidance
University Request for Goods or Services
ORACLE 12 GL CODE OVERVIEW
 |  | ** |  |  | ** | ** | ** | **
 | 1 | 2 | 3 | 4 | 5 | 6 | 7 | 8 | 9 | 10
 | Entity |  | Cost Centre |  | Project |  | Product |  | Geog.
 | | | Bus_Unit | | | Nom. Acc. | | | Activity | | | Job_code | | | Ico.

Examples
 | \|/ | | | \|/ | | | \|/ | | | \|/ | | | \|/
 | eg 01 | | | eg 4101 | | | Fyy-nnn-R | | | eg F181-MCS | | | eg G.B.
 | HWU | | | Ext. Goods | | | Relevant | | | BSc Mathematics with Comp Sc
 | eg21 | | | Proc | | | research project | | | With Comp Sci
 | HWT | \|/ | eg 4501 | \|/ | (If applicable) | \|/ | (If applicable) | \|/ |  | \|/
 | eg31 | eg 9948 | Ext Services | eg 5815 |  | eg T11 |  | Fyy-xxxx |  | eg 21
 | EBS | Procurement | Proc | Travel & |  | Teaching - |  | Relevant job code |  | HWT
 |  |  |  | Subsistence |  | Publicly Funded |  | (If applicable)
 | ** => COMPULSORY |  | If one of the blue highlighted is not applicable to the transaction leave blank <--
GUIDANCE NOTES: IF UNSURE SPEAK TO YOUR FINANCIAL CONTROLLER
(Based on current understanding)
1/. Entity |  | Apart from sales invoicing where we charge Vat, and any associated costs, .
 |  | this should be 01 for HWU 99.9% of the time and will default to this
2/. Business Unit |  | In the last version of Oracle everyone lived in a cost centre, in the new version Business Units are the income
 |  | drivers in the system and all transactions are in one of these
3/. Cost Centre |  | Will by default be automatically populated in Oracle by what is being done ( a Purchase order / Sales Invioice ).
4/. Nominal Account |  | Will by default be automatically populated in Oracle by what is being done ( a Purchase order / Sales Invioice ).
 |  | or a drop down box will allow the inputter to choose or change the nominal.
5/. Project |  | As before P.I.'s will be expected to know their project numbers and enter this on the forms - these have changed
 |  | from the previous version of Oracle - see Project tab. (The format is now F for MACS then the year the project
 |  | started e.g. 12 then a sequential number followed by the letter R if it is a Research project)
6/. Activity |  | There is a revised list of these and for Research a more detailled list of activity codes where it should be clear which
 |  | one should be used based on what is paying for what is being done.
7/. Product |  | Where a teaching purchase/travel etc transaction is being requested, this is the programme code for the "Product"
 |  | the money being spent from the budget has come from - see list on tab
8/. Job Code |  | If a job code is relevant to the purchase/travel activity then this needs to be completed - there is a new format for
 |  | these which should simply be "F99-" then for existing jobs, the current number e.g. KS001 (SISCSA)
 |  | New job codes will be supplied by the School Finance Office
9/. Geography |  | Will be mainly used by SAS for identifying the sources of students tuition fees.
10/. Intercompany |  | Will be mainly used for finance recharges of inter-university charges and costs.

Sheet: Suppliers
Supplier | Commodity | Supplier Contact | Email | Tel No | Website
4C Strategies | Computer Supplies & Services | Brian Cawley | bcawley@4c.co.uk | 01858 438938 | www.4c.co.uk
Aero Healthcare | Personal Protective Equipment & Clothing | Mark Gilmore | sales@aerohealthcare.co.uk | 0845 604 8280 | www.aerohealthcare.com
Air Liquide UK | Laboratory - Gas Purchase & Associated Rentals | Charles Dore | Charles.Dore@Airliquide.com | 07970 234264 | www.airliquide-iupcgases.co.uk
Air Products plc | Laboratory - Gas Purchase & Associated Rentals | Ruth Penuluna | penalur@airproducts.com | 01270 614765 | www.airproducts.com
Alba Travel (http://www.clydeextranets.com/content/travel/HeriotWatt/index.asp?showcontent=1) | Travel Services | Claire Gordon | cgordon@alba-travel.com | 01463 239188 | http://www.clydeextranets.com/content/travel/HeriotWatt/index.asp?showcontent=1
Alexandra Plc | Personal Protective Equipment & Clothing | Margaret Ritchie | Margaret.Ritchie@alexandra.co.uk | 0131 333 4455 | www.alexandra.co.uk
Alfa Aesar | Laboratory - Fine Chemicals | Julie Butterfield | julie.butterfield@alfa.com | 01524 850506 | www.alfa.com
Alpha Leisure Limited | Sports Equipment & Associated Services | Laura Melvin | laura@alpha-leisure.co.uk | 01224 899959 | www.alpha-leisure.co.uk
Alpha Office Furniture | Furniture | Karen Henney | karen@alphaofficefurniture.com | 01698 802690 | www.alphaofficefurniture.com
Anachem Ltd | Laboratory - Pipettes Supply & Service | Simon Renshaw | srenshaw@anachem.co.uk | 01582 745 181 | www.anachem-nwpls.co.uk
Andor Technology | Laboratory - Microscopes & Imaging | Garreth Sloan | g.sloan@andor.com | 028 9023 7126 | www.andor-tech.com
Apple Distribution International | Computer Supplies & Services | Apple Education Sales Team | uk.education@euro.apple.com | 0800 9120207 | www.apple.procureweb.ac.uk
Appleton Woods | Laboratory - General Equipment | Paul Murphy | paul.murphy@appletonwoods.co.uk | 0121 472 7353 | www.appletonwoods.co.uk
Aquarius X1 Ltd | Water Coolers | Joe Ishag | joe@aquariusxi.com | 0845 688 1202 | www.aquariusxi.com
Arco Limited | Cleaning Materials and Disposable Paper Products | Michael Brown | michael.brown@arco.co.uk | 01506 844661 | www.arco.co.uk
Arco Limited | Personal Protective Equipment & Clothing | Michael Brown | michael.brown@arco.co.uk | 01506 844661 | www.arco.co.uk
Arden Winch t/a Willis Safety | Personal Protective Equipment & Clothing | Chris Ross | cross@jkross.co.uk | 07802 558995 | www.ardenwinch.com
Arnold Clark | Car & Van Hire | Grace Hunter | grace.hunter@arnoldclark.co.uk | 01786 468700 | www.arnoldclark.com
Ashley Wilde Group | Window Coverings | Emma Brickwood | emmab@kaidistribution.co.uk | 01707 635 201 | www.kaidistribution.co.uk
Audio Visual Services | AV Equipment & Services | Audio Visual Services | mediaservices@hw.ac.uk | 0131 451 3019
Azzurro Ltd | Furniture | Alan Wales | Alan@azzurro-ltd.com | 07885 119 161 | www.azzurro-ltd.com
Beatson Building Supplies | Building Materials | John Fairley | johnf@beatsons.co.uk | 01968 670 061 | www.beatsons.co.uk
Becton Dickinson UK Ltd | Laboratory - Culture & Tissue Media | Joanne Blake | bduk_customerservice@europe.bd.com | 01865 781666 | www.bd.com/uk
Biohit-Pipette Doctor | Laboratory - Pipettes Supply & Service | Chris Wood | chrisw@biohit.co.uk | 01803 315900 | www.biohit.com
Biolegio | Laboratory - Oligo Bases & Custom Made Oligo | Zulfiqar (Zee) Majeed | z.majeed@biolegio.com | 07432 112476 | www.biolegio.com
Biotest (UK) Ltd | Laboratory - Culture & Tissue Media | Angela Davies | sales@biotestuk.com | 0121-733-3393 | www.biotestuk.com
Blue Arrow Ltd | Temporary Staff & Employment Agencies | Laura Van Zyl | laura.vanzyl@bluearrow.co.uk | 01582 692 926 | www.bluearrow.co.uk
Blue Direct Ltd | Water Coolers | James Anderton | janderton@bluedirect.co.uk | 01582 690550 | www.bluedirect.co.uk
BOC | Laboratory - Gas Purchase & Associated Rentals | Douglas Allan | Douglas.Allan@boc.com | 0777 444 8289 | www.bocinsight.com
BOC Safety Products | Personal Protective Equipment & Clothing | Ian Agnew | Ian.Agnew@boc.com | 0131 554 5582 | www.bocsafetyproducts.co.uk
BT | Computer Supplies & Services | Darren Mann | darren.mann@bt.com | 01691 664549 | www.bt.com/btinet
Budget Rent a Car and Van Rental | Car & Van Hire | Katherine Clements | Katherine.clements@budget-emea.com | O8445445338 | www.budget.co.uk
Bunzl Cleaning and Hygiene Supplies | Cleaning Materials and Disposable Paper Products | Karen Denney | karen.denney@bunzlchs.co.uk | 0141 842 4312 | www.bunzlchs.com
Bunzl Safety and Workwear Solutions | Personal Protective Equipment & Clothing | Andrea Abramson | andrea.abramson@bunzlsws.com | 01792 355526 | www.bunzlsws.com
Cairn Research | Laboratory - Microscopes & Imaging | Dr Martyn Reynolds | m.reynolds@cairn-research.co.uk | 017995 590 140 | www.cairn-research.co.uk
Calyx UK Ltd | Computer Supplies & Services | Neil Waterman | neil.waterman@calyxgroup.com | 01438 310872 | www.calyxgroup.com
Campbell Brothers Ltd | Meat, Poultry & Offal | Matthew Coulter | matt@campbellbrothers.co.uk | 0131 654 0060 | www.campbellbrothers.co.uk
Campbells Prime Meat Ltd | Fish & Seafood | Sandie Welham | sandie.welham@campbellsmeat.com | O1506675124 | www.campbellsmeat.com
Campbells Prime Meat Ltd | Meat, Poultry & Offal | Sandie Welham | sandie.welham@campbellsmeat.com | O1506675124 | www.campbellsmeat.com
Carl Zeiss Ltd. | Laboratory - Microscopes & Imaging | Clive Sherrard | micro@zeiss.co.uk | 01707 871200 | www.zeiss.co.uk
Christopher James Contracts Ltd | Window Coverings | Linda Adey | linda@curtaincontracts.co.uk | 01709 860 080 | www.curtaincontracts.co.uk
City Building (Contracts) LLP (RSBi) | Furniture | George Gaffney | George.Gaffney@citybuildingglasgow.co.uk | 0141 287 0800 | www.citybuildingglasgow.co.uk
City Electrical Factors | Electrical Sundries | Robin Parkin | robin.parkin@cef.co.uk | 0131 553 3346 | www.cef.co.uk
City Sprint UK Ltd | Courier Services | Nigel Cattermole | ncattermole@citysprint.co.uk | 07834 741 776 | www.citysprint.co.uk
Claremont Office Furniture Ltd | Furniture | Martin Fellowes | martin@claremontofficefurniture.com | 0141 419 3600 | www.claremontofficefurniture.com
Comet | Electrical White Goods & Associated Equipment | Jason Orchard | publicsector@comet.co.uk | 08444 992 121 | www.cometb2b.com/public-sector
Computerland | Computer Supplies & Services | Carol Woodhouse | carol.woodhouse@computerland.co.uk | 0115 931 8000 | www.computerlanduk.com
Cool Water Direct Ltd | Water Coolers | Will Watson | will@coolwaterdirect.com | 01484 862629 | www.coolwaterdirect.com
Crown Paints | Paint & Decorators Sundries | Michael Waddington | michael.waddington@crownpaints.co.uk | 01254 704951 | www.crowntrade.co.uk
Crown Relocations | External Office Removal Companies | Tammy Wilson | twilson@crownrelo.com | 01506 468 152 | www.crownrelo.com
Curtain and Blind Specialists (CBS) | Window Coverings | Andrew Trevett | sales@cbsblinds.co.uk | 01524 383 000 | www.cbsblinds.co.uk
Curtainwise (Scotland) Ltd | Window Coverings | William McKenzie | william@curtainwise.org.uk | 01290 420 101 | www.curtainwise.co.uk
David R Swann & Company | Personal Protective Equipment & Clothing | Paul Holmes | sales@drswann.co.uk | 028 2564 1245 | www.drswann.co.uk
Dell Computers Corporation Ltd | Computer Supplies & Services | Katrina Dore | Katrina_dore@dell.com | 0141 202 5262 | www.dell.co.uk
DHL Express UK Ltd | Courier Services | Thorsten Jochum | thorsten.jochum@dhl.com | 7841965911 | www.dhl.co.uk
Direct Today Couriers Ltd | Courier Services | Vahida Naeem | val@directtodayltd.com | 07970 839440 | www.directtoday.co.uk
Dot Hill | Computer Supplies & Services | David Thompson | david.thompson@dothill.com | 01256 781668 | www.dothill.com
E&E Workwear | Personal Protective Equipment & Clothing | Tony Ashton | eeworkwear@hotmail.com | 0161 427 6522 | www.eandeworkwear.co.uk
E&O Laboratories Ltd | Laboratory - Culture & Tissue Media | Ann Turner | ann.turner@eolabs.com | 01324 840404 | www.eolabs.com
Eden Springs (UK) Ltd | Water Coolers | Dave Smith | dave.smith@uk.edensprings.com | O8448003344 | www.edensprings.co.uk
Edmundson Electrical Ltd | Electrical Sundries | Graham Rennie | graham.rennie@eel.co.uk | 0151 424 7897 | www.edmundson-electrical.co.uk
Elkay Laboratory Products (UK) | Laboratory - Pipettes Supply & Service | Mark Tutty | a2@elkay-uk.co.uk | 01256 811118 | www.elkay-uk.co.uk
EMC Computer Systems (UK) Ltd | Computer Supplies & Services | Craig Thomson | Thomson_Craig@emc.com | 0870 608 7777 | www.emc.com
Enterprise Rent-a-Car | Car & Van Hire | Lindsey MacDonald | Lindsey.M.Macdonald@erac.com | 01786 479 100 | www.enterprise.co.uk
Ergo Computing UK Ltd | Computer Supplies & Services | Alastair Pursey | alastairp@ergo.co.uk | 0115 9144 160 | www.ergo.co.uk
Eurofins | Laboratory - Oligo Bases & Custom Made Oligo | Alex Goodwin | alexgoodwin@eurofins.com | 07717 366379 | www.eurofinsdna.com
Euroimmun UK Ltd | Laboratory - Microscopes & Imaging | Joanne Dimmock | j.dimmock@euroimmun.co.uk | 01495 364 444 | www.euroimmun.com
European Electronique Ltd | Computer Supplies & Services | Dave Castle | dave.castle@euroele.com | 0845 3458340 | www.euroele.com/nepa
Eveque Leisure Equipment Limited | Sports Equipment & Associated Services | Lynda Bliss | info@eveque.co.uk | 01606 353550 | www.eveque.co.uk
Fenestra Group | Window Coverings | Gerard Baxter | gerardb@workspacedesign.net | 0845 500 7080 | www.workspacedesign.net
Fisher Scientific UK Ltd | Laboratory - Consumables & Glassware | John Thomson | john.thomson@thermofisher.com | 07825 170280 | www.fisher.co.uk/contact
Fisher Scientific UK Ltd | Laboratory - Fine Chemicals | John Thomson | john.thomson@thermofisher.com | 07825 170280 | www.fisher.co.uk/contact
Fisher Scientific UK Ltd | Laboratory - Solvents, Alchohols, Acids & Deuterated Solvents | John Thomson | john.thomson@thermofisher.com | 07825 170280 | www.fisher.co.uk/contact
Fisher Scientific UK Ltd | Laboratory - General Equipment | John Thomson | john.thomson@thermofisher.com | 07825 170280 | www.fisher.co.uk/contact
Flexiform Business Furniture Limited | Furniture | Steven Bow | stevenb@flexiform-scotland.co.uk | 01506 416 410 | www.flexiform.co.uk
Foams 4 Sports | Sports Equipment & Associated Services | Mark Hart | mark@foams4sports.co.uk | 07900 802068 | www.foams4sports.co.uk
Forbo Flooring UK Ltd | Floor Coverings | Philippa Nicholl | philippa.nicholl@forbo.com | 01592 643 777 | www.forbo-flooring.co.uk (http://www.dell.co.uk/education)
Ford Rental | Car & Van Hire | Mandie Pelletier | mandie.pelletier@fordrental.co.uk | 01480 222 057 | www.ford.co.uk
Ford's the Bakers | Bakery Products | Graeme Hayes | ghayes@fordsthebakers.co.uk | 01875 814000 | www.mcgheesbakery.co.uk
Fresh Direct Local (Scotland) Ltd | Fruit & Vegetables | Ken Brechin | ken.brechin@freshdirect.co.uk | 0141 552 3424 | www.freshdirect.co.uk
George Anderson and Sons | Fruit & Vegetables | Ken Wright | ken@georgeanderson.co.uk | 01875 616950 | www.georgeanderson.co.uk
George Campbell & Sons (FishMongers) Ltd | Fish & Seafood | Yvonne Rae | yvonner@georgecampbellandsons.co.uk | 01738 638 454 | www.georgecampbellandsons.co.uk
Getech Ltd | Computer Supplies & Services | Carl Gibbs | cgibbs@getech.co.uk | 01473 243435 | www.getech.com
Godfrey Syrett Ltd | Furniture | Wynn Morris | wynn.morris@godfreysyrett.co.uk | 07818 564 408 | www.godfreysyrett.co.uk
Gordon & Halliday | Floor Laying | Craig Gordon | craig@gordon-halliday.co.uk | 07774 103514 | n/a
Goss Scientific Instruments Ltd | Laboratory - Solvents, Alchohols, Acids & Deuterated Solvents | Michelle Griffiths | sales@gossinst.co.uk | 01270 611590 | www.gossinst.co.uk
Gradus Ltd | Floor Coverings | Alan Cadzow | alan.cadzow@gradusworld.com | 01625 428 922 | www.gradusworld.com
Grafton Merchanting GB Ltd (Buildbase) | Timber Products | Ross Cooke | rcooke@pdmltd.co.uk | 07824 409 555 | www.buildbase.co.uk
Grafton Merchanting GB Ltd(Plumbline) | Building Materials | Ross Cooke | rcooke@pdmltd.co.uk | 07824 409555 | www.plumbline.co.uk/home
Grafton Optical Company Ltd | Laboratory - Microscopes & Imaging | Malcolm Redfearn | sales@graftonoptical.com | 01923 233 980 | www.graftonoptical.com
Graham’s The Family Dairy | Dairy Produce | Albert Hope | albert.hope@grahamsfamilydairy.com | 07887 946761 | www.grahamsfamilydairy.com
Greiner Bio-One Ltd | Laboratory - Consumables & Glassware | Fred Brewster | fred.brewster@gbo.com | 01453 825255 | www.gbo.com
Gresham Office Furniture Ltd | Furniture | Carol Hughes | carol.hughes@gof.co.uk | 07943 808 493 | www.gof.co.uk
Gym-Master | Sports Equipment & Associated Services | Jason Bowers | jasonbowers@gym-master.co.uk | 0161 830 0003 | www.gym-master.co.uk
H Squared Electronics Ltd | Electrical Components | Colin Wilkinson | colinwilkinson@h-squared.co.uk | 07595 200416 | www.h-squared.co.uk
Hardedge Limited | Personal Protective Equipment & Clothing | Liz Maxfield | liz@hard-edge.co.uk | O1902354526 | www.hardedgeonline.co.uk
Hardman Isherwood | Electrical White Goods & Associated Equipment | Tracy Buxton | traceybuxton@hidistribution.co.uk | 01924 227 350 | www.hidistribution.co.uk
HCS Business Interiors | Furniture | Stuart Buckley | Stuart.Buckley@hcs-bi.co.uk | 0141 646 1551 | www.hcsuk.org
Hitachi Data Systems Ltd | Computer Supplies & Services | Mark Shaw | mark.shaw@hds.com | 07824 451685 | www.hds.com
Horizon Soft Drinks Ltd | Water Coolers | James Quiggin | j.quiggin@horizondrinks.co.uk | 0845 0692837 | www.horizondrinks.com
HP Ltd (Direct) | Computer Supplies & Services | Andrew Hendry | andrew.hendry@hp.com | O7747866513 | www.hp.co.uk
HP via DTP Group | Computer Supplies & Services | Andy Parkes | aparkes@dtpgroup.co.uk | 0113 276 0210 | www.dtpgroup.co.uk
HP via RM | Computer Supplies & Services | Paul Flack | pflack@rm.com | 01235 826548 | www.rm.com/he
IBM | Computer Supplies & Services | Robert Tickell | robert_tickell@uk.ibm.com | 020 8818 5172 | www.ibm-nssa.co.uk
ICI Paints | Paint & Decorators Sundries | Joe Baxter | joe.baxter@akzonobel.com | 0870 600 5300 | www.icipaints.co.uk
ICM Business Continuity | Computer Supplies & Services | Terry Sheridan | terry.sheridan@icm-continuity.co.uk | 0121 380 2000 | www.icm.co.uk
Image Solutions | Laboratory - Microscopes & Imaging | Tim Fletcher | tim@imsol.co.uk | 01772 663 140 | www.imsol.co.uk
Initial Washroom Services | Sanitary Disposal,Related Products & Services | Claire Keating | claire.keating@rentokil-initial.com | 07787 151 218 | www.initial.co.uk
Instock Disposables | Cleaning Materials and Disposable Paper Products | Keith Goodwin | keith.instock@gmail.com | 07703 581 400 | www.Instockgroup.co.uk
Integrated DNA Technologies (IDT) | Laboratory - Oligo Bases & Custom Made Oligo | Caron Wilson | cwilson@idtdna.com | 07506 046152 | www.idtdna.com
Integrated Fitness Services | Sports Equipment & Associated Services | Sharlene Watson | Sharlene.watson@inspirit.co.uk | 01628 672809 | www.inspirit.co.uk
Intelligent Imaging Innovations | Laboratory - Microscopes & Imaging | Dr Benjamin Atkinson | 3ieurope@intelligent-imaging.com | +44 207 371 6639 | www.intelligent-imaging.com
Interface Europe Ltd | Floor Coverings | Neil McBrier | neil.mcbrier@interfaceflor.eu | 0773 658 381 | www.interfaceeurope.co.uk
Ionscope Ltd | Laboratory - Microscopes & Imaging | Robert Field | rob@ionscope.com | 1763269070 | www.ionscope.com
Jewson Ltd | Building Materials | Nicola Lee | nicola.lee@jewson.co.uk | 0141 550 6100 | www.jewson.co.uk
Jewson Ltd | Timber Products | Nicola Lee | nicola.lee@jewson.co.uk | 0141 550 6100 | www.jewson.co.uk
John Astley & Sons Limited | Personal Protective Equipment & Clothing | Stacy Hands | stacy.hands@astleys.co.uk | 02476 854545 | www.astleys.co.uk
Kinesis Ltd | Laboratory - Pipettes Supply & Service | Sara Winters | saraw@kinesis.co.uk | 01480 212122 | www.kinesis.co.uk
Kings Wholesale Fabrics Ltd | Window Coverings | Elizanne McKeon | admin@kingsfabrics.com | 0141 556 1147 | www.kingsfabrics.co.uk
Lab Mode | Laboratory - General Equipment | Gary Broomhead | gary.broomhead@labmode.co.uk | 01908 768 000 | www.labmode.co.uk
Lake Image Systems Ltd | Laboratory - Microscopes & Imaging | David Rudeforth | drudeforth@lakeimage.com | 01442 892 700 | www.lakeimage.com
Lanfine Ltd | Window Coverings | Pauline Bruce | Pauline@lanfine.co.uk | 01560 321278 | www.lanfine.co.uk
Langstane Press Ltd | Furniture | John Lister | john.lister@langstane.co.uk | 0131 669 0032 | www.langstane.co.uk
Lanway Corp Bus Systems Ltd | Computer Supplies & Services | Andrew Henderson | a.henderson@lanway.co.uk | 01282 418852 | www.itrap-lanway.co.uk
Laser 2000 | Laboratory - Microscopes & Imaging | Peter Collins | peterc@laser2000.co.uk | 01933 461 666 | www.laser2000.co.uk
LaVision Biotec GmbH | Laboratory - Microscopes & Imaging | Erik Von Stedingk | vonstedingk@lavisionbiotec.com | +49 521 2997 710 | www.lavisionbiotec.com
Leica Microsystems (UK) Ltd | Laboratory - Microscopes & Imaging | Ian Andrews | ian.andrews@leica-microsystems.com | 01908 246 296 | www.leica-microsystems.com
Lewis`s Medical Supplies | Personal Protective Equipment & Clothing | Kerry Malseed | kmalseed@lewis-plast.co.uk | 07921 212694 | www.lewis-plast.co.uk
Life Fitness UK Limited | Sports Equipment & Associated Services | Nick Mennell | nick.mennell@lifefitness.com | 07825 362 461 | www.lifefitness.com
Logicalis Ltd | Computer Supplies & Services | Russell Evans | russell.Evans@Uk.Logicalis.com | 01753 777244 | www.uk.logicalis.com
M&J Seafoods | Fish & Seafood | Simon Marr | simon.marr@brake.co.uk | 077688 030072 | www.mjseafood.com
Magiboards Ltd | Furniture | Erwin Van Der Stap | sales@magiboards.com | 01952 292111 | www.magiboards.com
Mark Murphy & Partner Ltd | Fruit & Vegetables | John Bastianelli | johnb@markmurphyltd.co.uk | 0131 335 3040 | www.markmurphyltd.co.uk
Mast Group Ltd | Laboratory - Culture & Tissue Media | Morna McRae | mcrae@mastgrp.com | 0151 933 7277 | www.mastgrp.com
MCD Scotland Ltd | Floor Coverings | Graham Halliday | jim.mcgregor@mcdscotland.co.uk | 01698 808 009 | www.mcdscotland.co.uk
Media for Mycobacteria | Laboratory - Culture & Tissue Media | Jacqueline Jeakins | mediaformycobact@btconnect.com | 01446 740100 | n/a
MGM Timber (Scotland) Ltd | Timber Products | Brian Smith | brian.smith@mgmtimber.com | 01738 472 036 | www.mgmtimber.co.uk/
Microscopy Supplies and Consultants | Laboratory - Microscopes & Imaging | Angela Hocking | angela@msac-uk.com | 01383 851 434 | www.microscopysuppliesandconsultantsltd.com
Milliken Carpets Ltd | Floor Coverings | Joyce Main | joyce.main@milliken.com | 07836 580 134 | www.millikencarpet.com
Misco Computer Supplies Ltd | Computer Supplies & Services | Alex Allison | aali@misco.co.uk | 0870 724 4812 | www.misco.co.uk
Muir Group Interiors Ltd | Window Coverings | Catherine Crawford | admin@muirgroupinteriors.co.uk | 0141 880 8844 | www.muirgroupinteriors.co.uk
NEC Computers Ltd | Computer Supplies & Services | David Carral | david.carral@eu.nec.com | 07885 996130 | www.nec.com
Nikon UK ltd | Laboratory - Microscopes & Imaging | Tom Lawson | tom.lawson@nikon.co.uk | 020 8481 6894 | www.europe-nikon.com
Norland Managed Services Ltd | Computer Supplies & Services | Timothy Brown | Timothy.brown@norlandmanagedservices.co.uk | 0161 877 0218 | www.norlandmanagedservices.co.uk
OCS Group t/a Cannon | Sanitary Disposal,Related Products & Services | Carole Fletcher | carole.fletcher@cannonhygiene.com | 07771 971 864 | www.ocs.co.uk
Office Depot | Office Stationery & Paper | Samantha Campbell | Samantha.Campbell@OfficeDepot.com | 07768 475844 | www.online.officedepot.co.uk
Olympus Keymed | Laboratory - Microscopes & Imaging | bernadette harknett | tenders@olympus.co.uk. | 01702 616333 | www.olympuskeymed.com
Onecall | Electrical Components | Andrew Dorans | adorans@farnellinone.co.uk | 07889 829 486 | www.onecall.farnell.com
Oxoid Ltd | Laboratory - Culture & Tissue Media | Stephen Lees | stephen.lees@thermofisher.com | 01256 694315 | www.oxoid.co.uk
Parcelforce (Royal Mail) | Courier Services | Eugene Reynolds | eugene.reynolds@parcelforce.co.uk | 07711 032066 | www.royalmailgroup.com
Peelmount Contract Furnishings Limited | Electrical White Goods & Associated Equipment | Karen Cook | kcook@peelmount.co.uk | 0161 817 2508 | www.peelmount.co.uk
Perkin Elmer LAS (UK) Ltd | Laboratory - Microscopes & Imaging | Robert Lee | Bob.R.Lee@perkinelmer.com | 01494 874515 | www.las.perkinelmer.co.uk
Photometrics UK | Laboratory - Microscopes & Imaging | Matt Preston | mpreston@photomet.com | 01628 477 025 | www.photomet.co.uk
Photon Lines Ltd | Laboratory - Microscopes & Imaging | David Gibson | da-gibson@photonlines.com | 01295 724 225 | www.photonlines.co.uk
PHS Group | Sanitary Disposal,Related Products & Services | Gareth Stagg | garethstagg@phs.co.uk | 02920 809 173 | www.phs.co.uk
Plumbing Trade Supplies (PTS) | Plumbing & Heating Consumables | Peter Scullion | p.scullion@bssgroup.com | 01786 434828 | www.ptsplumbing.co.uk
Powerhouse Fitness Equipment | Sports Equipment & Associated Services | Gianna Rinaldi | giannar@powerhouse-fitness.co.uk | 0141 876 3973 | www.powerhouse-fitness.co.uk
PPG Architectural | Paint & Decorators Sundries | Lucy Oates | lucy.oates@ppg.com | 01924 354000 | www.ppg.com
Pressure Coolers Ltd t/a Maestro International | Water Coolers | Brian Gorman | briang@maestrointl.co.uk | 01704 876 710 | www.pressurecoolers.co.uk
Primo IT | Computer Supplies & Services | Craig Pattison | craig@primoit.co.uk | 01530 265664 | www.primoit.co.uk
Procurement Services | Furniture - 2nd Hand, Storage, Deliveries & Removals | Brian Dempster | B.Dempster@hw.ac.uk | 0131 451 3710
Project | Floor Coverings | John Allan | sales@projectflooringsscotland.co.uk | 01698 834 141 | www.projectflooring-online.co.uk
Rackline Ltd | Furniture | Daniel Laurie | daniel.laurie@rackline.co.uk | 07795 358 635 | www.rackline.com
Rexel | Electrical Sundries | Lance Little | lance.little@rosselec.co.uk | 07768 031704 | www.rexel.co.uk
Rexel t/a Parker Marketing | Personal Protective Equipment & Clothing | David Shaw | david.shaw@parkermerchanting.co.uk | 07715 053997 | www.parker-direct.com
Reynolds Catering Supplies Ltd | Fruit & Vegetables | Debbie Coxon | deborah.coxan@reynolds-cs.com | 0845 310 6200 | www.reynolds-cs.com
RM Education plc | Computer Supplies & Services | Andy Lowe | alowe@rm.com | 0800 0197908 | www.rm.com/he
RS Components Ltd | Electrical Components | Marie Dougan | marie.dougan@rswww.com | 07739 821431 | www.uk.rs-online.com
Russell Hume Ltd | Meat, Poultry & Offal | Ian Gould | Scotland@russellhume.co.uk | 01383 421 979 | www.russellhume.com
Samsung via Getech | Computer Supplies & Services | Gerry Kane | gkane@getech.co.uk | 01473 243415 | www.getech.co.uk
Samsung via Stone | Computer Supplies & Services | Antony Mellor | antony.mellor@stonecomputers.com | 01785 285618 | www.stonecomputers.com
Scientific & Chemical Supplies Ltd | Laboratory - Microscopes & Imaging | Jim Mackle | jim.mackle@scichem.com | 7712930478 | www.scichem.com
Scientific Laboratory Supplies Ltd | Laboratory - Consumables & Glassware | Keith Jackson | kjackson@scientific-labs.com | 01236 431857 | www.scientificlabs.co.uk
Scientific Laboratory Supplies Ltd | Laboratory - Microscopes & Imaging | Keith Jackson | kjackson@scientific-labs.com | 01236 431857 | www.scientificlabs.co.uk
Scientific Laboratory Supplies Ltd | Laboratory - Pipettes Supply & Service | Keith Jackson | kjackson@scientific-labs.com | 01236 431857 | www.scientificlabs.co.uk
Scientific Laboratory Supplies Ltd | Laboratory - Solvents, Alchohols, Acids & Deuterated Solvents | Keith Jackson | kjackson@scientific-labs.com | 01236 431857 | www.scientificlabs.co.uk
Scientific Laboratory Supplies Ltd | Laboratory - General Equipment | Keith Jackson | kjackson@scientific-labs.com | 01236 431857 | www.scientificlabs.co.uk
Sci-Quip | Laboratory - General Equipment | Deborah Williams | dwilliams@sciquip.co.uk | 01939 291200 | www.sciquip.co.uk
Sigma-Aldrich Company Ltd | Laboratory - Fine Chemicals | Hannah Bunten | Hannah.Bunten@sial.com | 01202 712326 | www.sigmaaldrich.com
Sigma-Aldrich Company Ltd | Laboratory - Oligo Bases & Custom Made Oligo | Hannah Bunten | Hannah.Bunten@sial.com | 01202 712326 | www.sigmaaldrich.com
Sigma-Aldrich Company Ltd | Laboratory - Solvents, Alchohols, Acids & Deuterated Solvents | Hannah Bunten | Hannah.Bunten@sial.com | 01202 712326 | www.sigmaaldrich.com
SJ Electronics | Electrical Components | Melvin Crane | m.crane@sjelectronics.co.uk | 0800 583 4455 | www.sjelectronics.co.uk
Smith Scientific Ltd | Laboratory - Consumables & Glassware | Joe Webb | joe.webb@smithscientific.co.uk | 01732 864 864 | www.smithscientific.co.uk
Spectrum Computer Supplies | Computer Supplies & Services | Jonathan Bainbridge | jonathan.bainbridge@spectrumltd.co.uk | 01274 767758 | www.spectrumltd.co.uk
Speed One Sports | Personal Protective Equipment & Clothing | Brian Baumber | brian.baumber@speedonesports.co.uk | 0845 124 9758 | www.speedonesports.com
Sports Warehouse (Edinburgh) | Sports Equipment & Associated Services | Douglas Livingstone | douglas@sportswarehouse.co.uk | 0131 553 6003 | www.sportswarehouse.co.uk
Star Trac (Anytime Leisure) | Sports Equipment & Associated Services | Paul Bodger | paul@anytimeleisure.com | 07515 469888 | www.startrac.com
Starlab (UK) Ltd | Laboratory - Pipettes Supply & Service | Denise Fane de Salis | dfanedesalis@starlab.co.uk | 01908 283 800 | www.starlab.co.uk
Stern Electric Company Limited | Electrical White Goods & Associated Equipment | Raymond McGuire | Raymond.McGuire@stearn.co.uk | 0141 221 2674 | www.stearn.co.uk
Stone Computers Ltd | Computer Supplies & Services | Antony Mellor | antony.mellor@stonecomputers.com | 01785 285618 | www.stonecomputers.com
Sun Microsystems | Computer Supplies & Services | Rod McAllister | rod.mcallister@oracle.com | 01506 672234 | www.uk.sun.com
Sungard Availability Services | Computer Supplies & Services | Paul Whistance | paul.whistance@sungard.com | 020 8080 8161 | www.sungard.co.uk (http://www.fisher.co.uk/contact)
Sunrite Blinds Ltd | Window Coverings | Lynne Cooper | sunritecontracts@aol.com | 0131 665 9933 | www.sunrite.co.uk
Symon Of Edinburgh | Window Coverings | Donald Symon | djs@symon-edinburgh.co.uk | 0131 660 6611 | www.symon-edinburgh.co.uk
TCS Biosciences Ltd | Laboratory - Culture & Tissue Media | Melanie Hatton | sales@tcsgroup.co.uk | 01296 714222 | www.tcsbiosciences.co.uk
Teacher Boards (1985) Ltd | Furniture | Sarah Greenbank | Sarah.Greenbank@teacherboards.co.uk | 01236 821 894 | www.teacherboards.co.uk
Technogym UK Ltd | Sports Equipment & Associated Services | Andy Davidson | adavidson@technogym.com | 07899 661757 | www.technogym.co.uk
Telindus | Computer Supplies & Services | Mark Thornton | mark.thornton@telindus.co.uk | 01276 406309 | www.telindus.co.uk
Thomas Owen & Sons Limited | Personal Protective Equipment & Clothing | Justin Bultitude | justin.bultitude@thomasowen.co.uk | 07712 790338 | www.thomasowen.co.uk
TILL Photonics GmbH | Laboratory - Microscopes & Imaging | Olaf Michalski | sales@till-photonics.com | 0049 89 895 662 121 | www.till-photonics.com
TNT Uk Ltd | Courier Services | Johanne Whitehouse | purchasingconsortia@tnt.co.uk | 01530 410133 | www.tnt.co.uk
Toshiba via Viglen | Computer Supplies & Services | Mark Bailey | mark.bailey@viglen.co.uk | 01727 201798 | www.viglen.co.uk
Toshiba via XMA | Computer Supplies & Services | Hayley Smith | hayley.smith@xma.co.uk | 0115 846 4999 | www.xma4education.co.uk
Total Produce | Fruit & Vegetables | Wilson Neil | wneil@totalproduce.com | O131 4586035 | www.totalproduce.com
Travis Perkins (Keyline) | Building Materials | Cameron Baptie | cameron.baptie@travisperkins.co.uk | 01604 596121 | www.keyline.co.uk
Trinity Workwear | Personal Protective Equipment & Clothing | James Clarke | james@trinityworkwear.co.uk | 07780 550693 | www.trinityworkwear.co.uk
Triumph Furniture Company Limited | Furniture | Ross Hart | rhart@triumphfurniture.com | 01685 352 211 | www.triumph-tbs.com
V Tech SMT Ltd | Laboratory - Microscopes & Imaging | Derek Walker | jade@vtech-smt.co.uk | 01786 813 999 | www.vtech-smt.co.uk
Viglen Ltd | Computer Supplies & Services | Mark Bailey | mark.bailey@viglen.co.uk | 01727 201798 | www.viglen.co.uk
VisiTech International | Laboratory - Microscopes & Imaging | Steven Coleman | steven.coleman@visitech.co.uk | 0191 516 6255 | www.visitech.co.uk
VWR International Ltd | Laboratory - Consumables & Glassware | Eilidh Lawson | eilidh.lawson@uk.vwr.com | 07803 850 507 | www.uk.vwr.com
VWR International Ltd | Laboratory - Microscopes & Imaging | Eilidh Lawson | eilidh.lawson@uk.vwr.com | 07803 850 507 | www.uk.vwr.com
VWR International Ltd | Laboratory - Pipettes Supply & Service | Eilidh Lawson | eilidh.lawson@uk.vwr.com | 07803 850 507 | www.uk.vwr.com
VWR International Ltd | Laboratory - Solvents, Alchohols, Acids & Deuterated Solvents | Eilidh Lawson | eilidh.lawson@uk.vwr.com | 07803 850 507 | www.uk.vwr.com
VWR International Ltd | Laboratory - General Equipment | Eilidh Lawson | eilidh.lawson@uk.vwr.com | 07803 850 507 | www.uk.vwr.com
Wabbo Ltd | Art Supplies | Gerard Stearman | sales@wabbo.co.uk | 01530 412885 | www.wabbo.co.uk
Whitaker &Sons | Electrical White Goods & Associated Equipment | Tina Moscrop | tina.moscrop@whitakerservices.co.uk | 01706 758 358 | www.whitakerservices.co.uk
William Irvine & Sons Ltd | Upholstery & Pinboards | Derek Irvine | sales@irvines.biz | 0131 337 4974 | n/a
William Wilson Ltd | Plumbing & Heating Consumables | Malcolm Findlay | malcolm.findlay@williamwilson.co.uk | 01224 877522 | www.williamwilson.co.uk
Wolf Laboratories | Laboratory - General Equipment | David Child | david.child@wolflabs.co.uk | 01759 301142 | www.wolflabs.co.uk
Xenon Network Services Ltd | Computer Supplies & Services | Carl Gleeson | info@xenon-uk.co.uk | O1619295282 | www.xenon-uk.co.uk
XMA Ltd | Computer Supplies & Services | Tony Ryan | tony.ryan@xma.co.uk | 07896 166685 | www.xma4education.co.uk
