SeunOjuoko/AssemblyRobot/15_Supportingfiles/Robot Arm STL Files/1stArm.STL

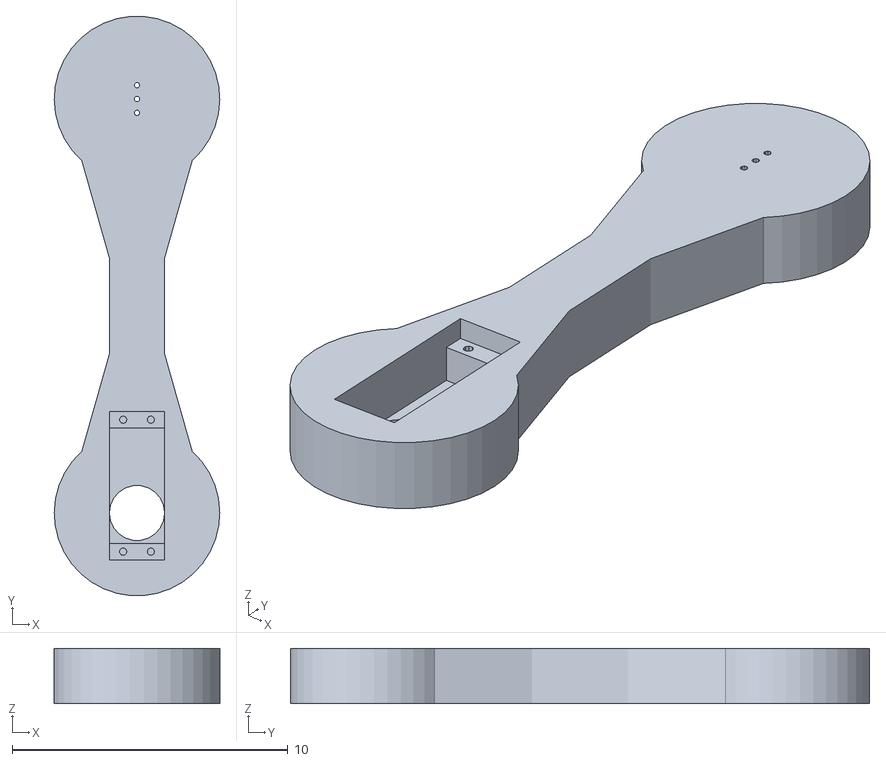
[picture p41: CAD file, 2022-12-14]
15_Supportingfiles/Robot Arm STL Files/1stArm.STL
6.00 x 21.0 x 2.00
