SeunOjuoko/AssemblyRobot/CAD for Physical Build/STL/NeWConceptV2.0.STL

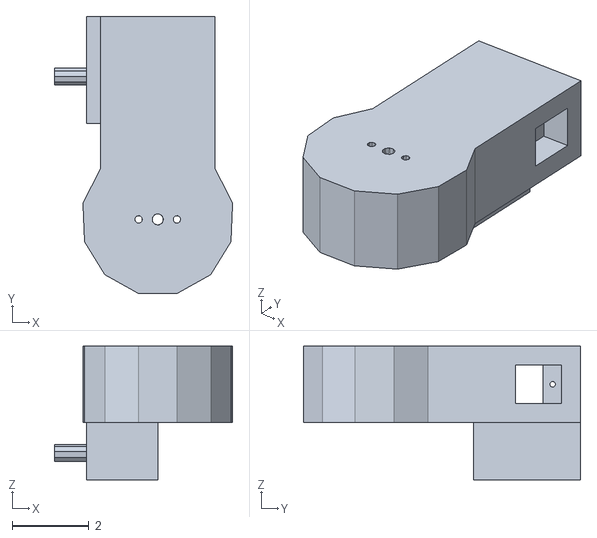
[picture p42: CAD file, 2022-12-14]
CAD for Physical Build/STL/NeWConceptV2.0.STL
4.65 x 7.24 x 3.50
