SeunOjuoko/AssemblyRobot/Final CAD/PARTS FOR PRINT (STL)/New Gear.STL

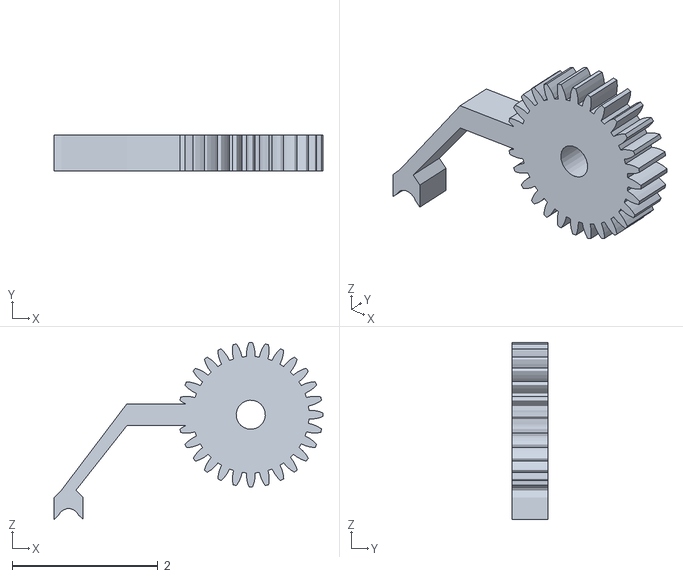
[picture p43: CAD file, 2022-12-14]
Final CAD/PARTS FOR PRINT (STL)/New Gear.STL
3.69 x 0.5 x 2.43
