SeunOjuoko/AssemblyRobot/Final CAD/Pintingz/STL/Cylinder.STL

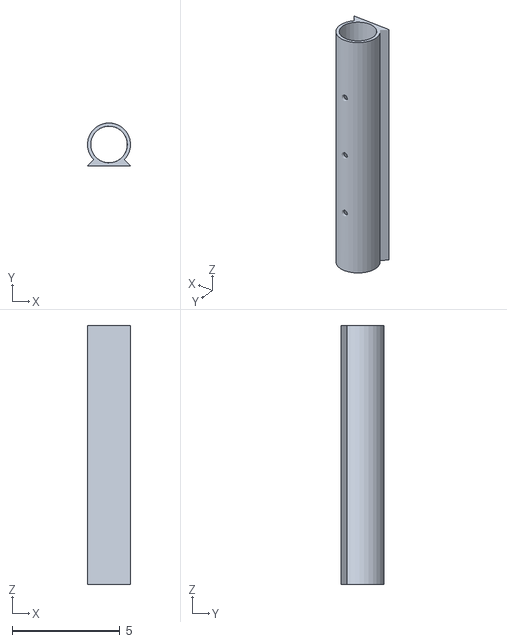
[picture p44: CAD file, 2022-12-14]
Final CAD/Pintingz/STL/Cylinder.STL
2.00 x 2.00 x 12.0
