SeunOjuoko/AssemblyRobot/Final Grippers/Servo new gearSTL.STL

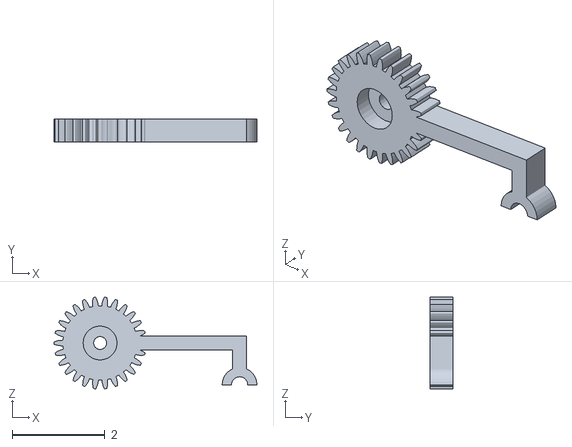
[picture p45: CAD file, 2022-12-14]
Final Grippers/Servo new gearSTL.STL
4.37 x 0.5 x 1.97
