SeunOjuoko/AssemblyRobot/FinalNewbaseTopSTL.STL

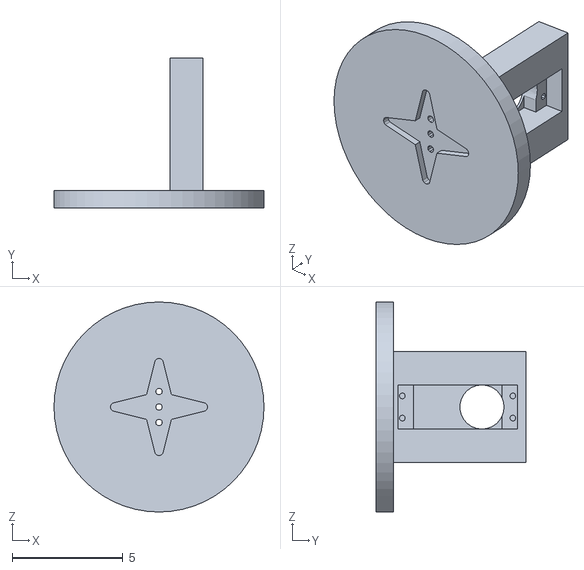
[picture p46: CAD file, 2022-12-14]
FinalNewbaseTopSTL.STL
9.50 x 6.80 x 9.50
