SeunOjuoko/AssemblyRobot/NewEndParts/Base top w servo housing1.STL

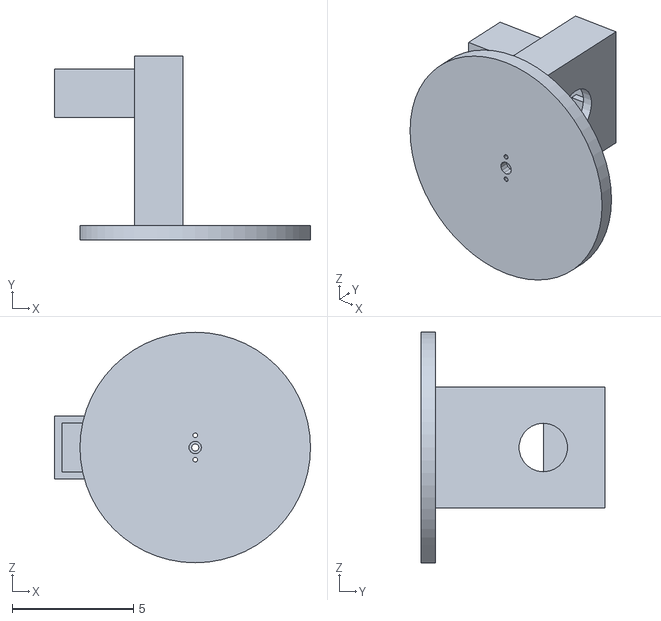
[picture p47: CAD file, 2022-12-14]
NewEndParts/Base top w servo housing1.STL
10.6 x 7.60 x 9.50
