SeunOjuoko/AssemblyRobot/NewEndParts/Been Printed/NewConceptArm servo.STL

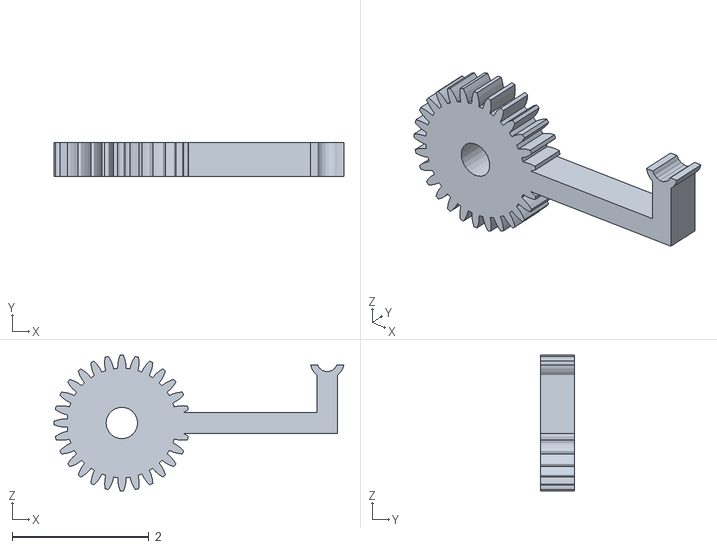
[picture p48: CAD file, 2022-12-14]
NewEndParts/Been Printed/NewConceptArm servo.STL
4.24 x 0.5 x 1.98
