SeunOjuoko/AssemblyRobot/NewEndParts/New Shape (V2) Ends/NewConceptArm free V2.stl

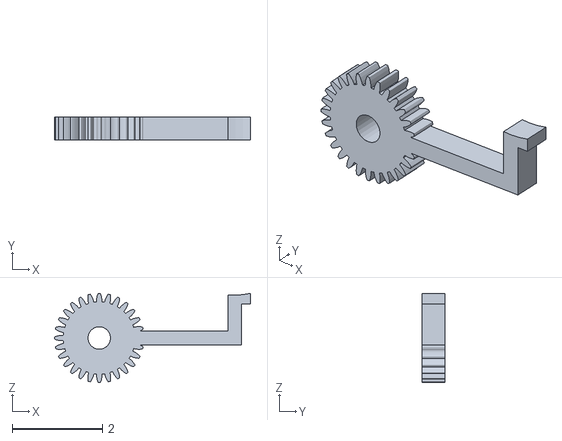
[picture p49: CAD file, 2022-12-14]
NewEndParts/New Shape (V2) Ends/NewConceptArm free V2.stl
4.34 x 0.5 x 1.98
