SeunOjuoko/AssemblyRobot/Pin parts/Pin CylinderSTL.STL

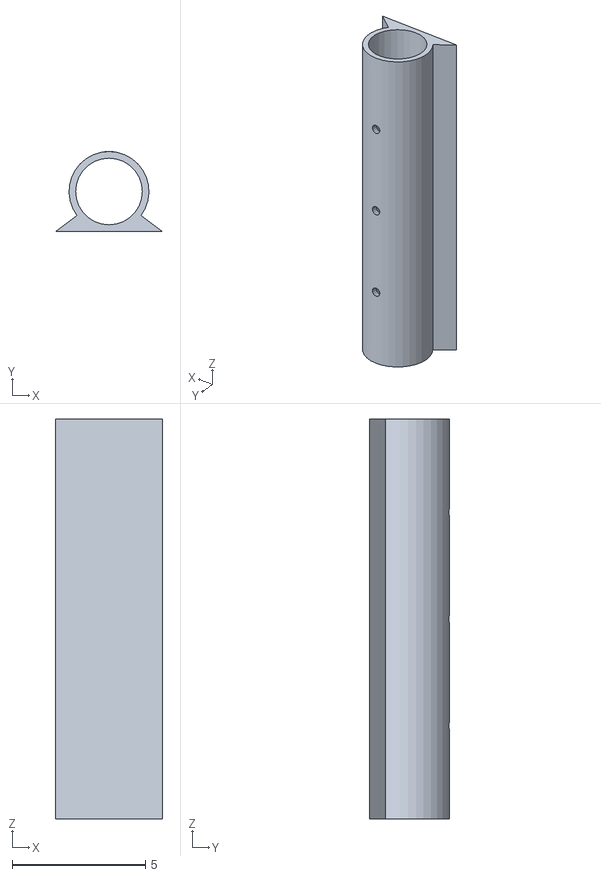
[picture p50: CAD file, 2022-12-14]
Pin parts/Pin CylinderSTL.STL
4.00 x 3.00 x 15.0
