SeunOjuoko/AssemblyRobot/CAD for Physical Build/STL/2ndArm.STL

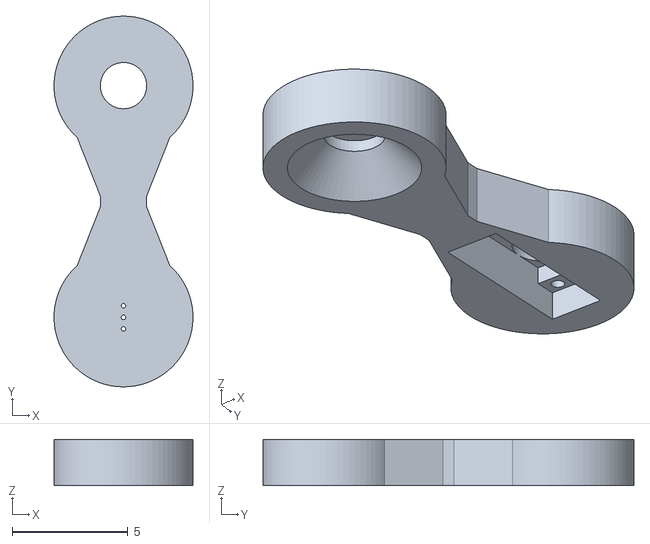
[picture p51: CAD file, 2022-12-14]
CAD for Physical Build/STL/2ndArm.STL
6.00 x 16.0 x 2.00
