SeunOjuoko/AssemblyRobot/Final CAD/Pintingz/STL/Pin holder.STL

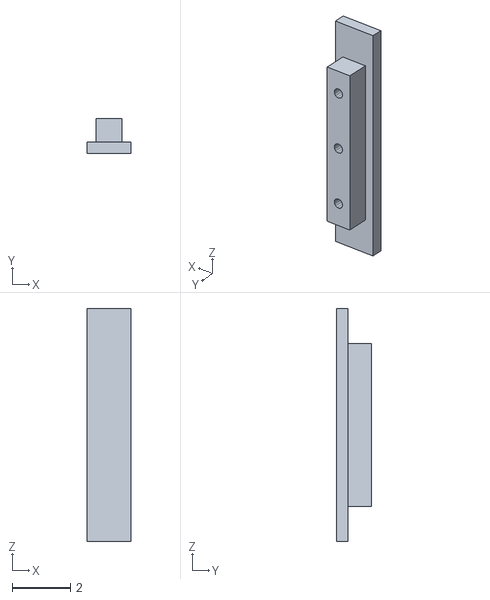
[picture p52: CAD file, 2022-12-14]
Final CAD/Pintingz/STL/Pin holder.STL
1.50 x 1.20 x 8.00
