SeunOjuoko/AssemblyRobot/Final Grippers/Free gearSTL.STL

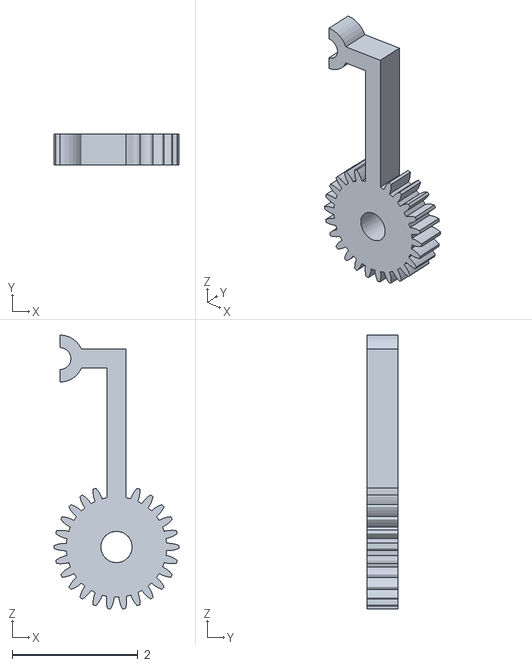
[picture p53: CAD file, 2022-12-14]
Final Grippers/Free gearSTL.STL
1.98 x 0.5 x 4.36
