SeunOjuoko/AssemblyRobot/Pin parts/Pin.STL

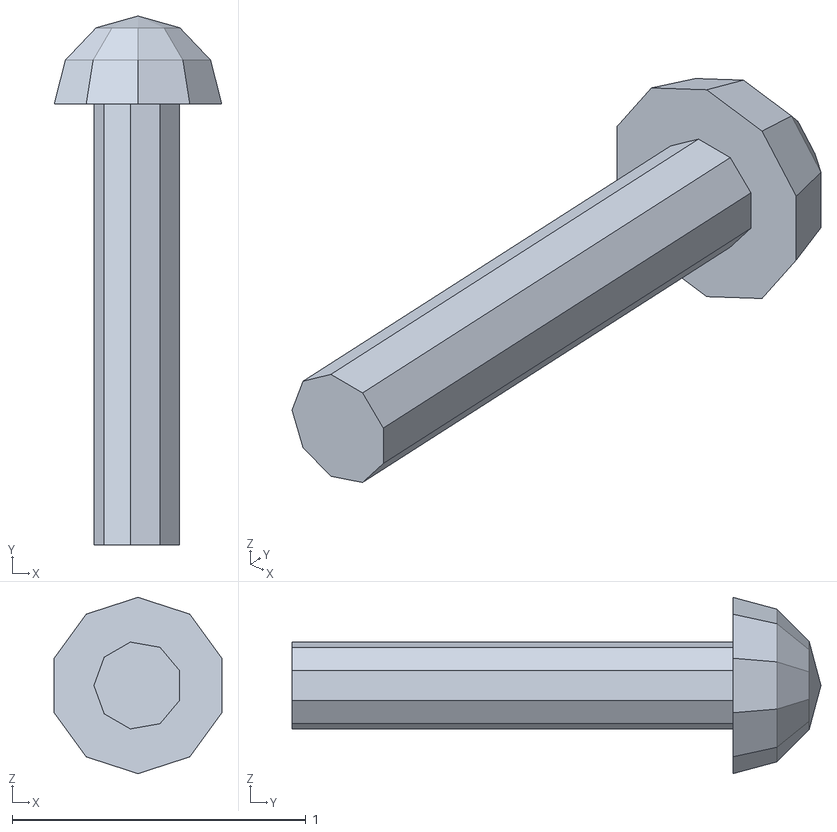
[picture p54: CAD file, 2022-12-14]
Pin parts/Pin.STL
0.571 x 1.80 x 0.6
