SeunOjuoko/AssemblyRobot/CAD for Physical Build/STL/NBase Part..STL

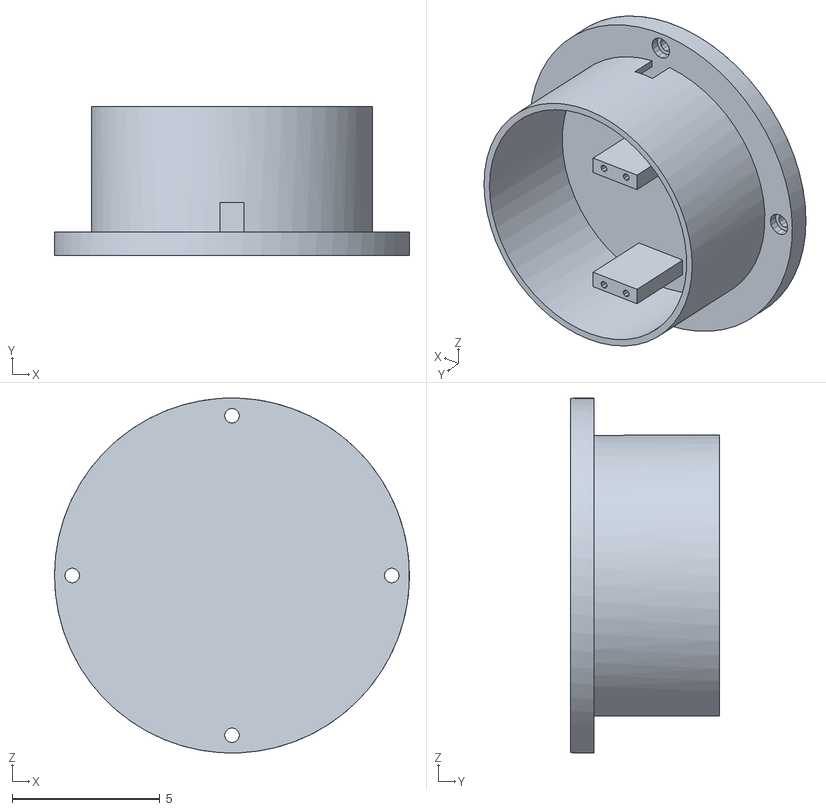
[picture p55: CAD file, 2022-12-14]
CAD for Physical Build/STL/NBase Part..STL
12.0 x 5.05 x 12.0
