SeunOjuoko/AssemblyRobot/Final CAD/PARTS FOR PRINT (STL)/Solo (SG) Gear.STL

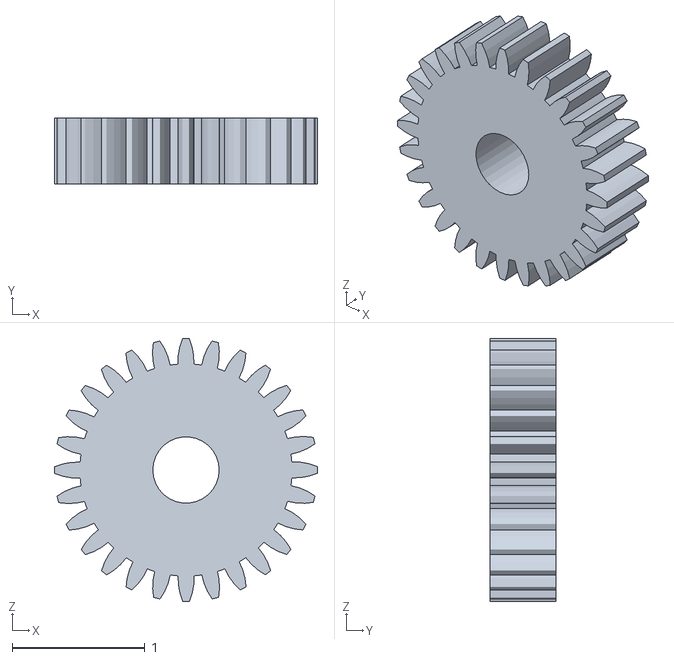
[picture p56: CAD file, 2022-12-14]
Final CAD/PARTS FOR PRINT (STL)/Solo (SG) Gear.STL
1.98 x 0.5 x 1.98
