SeunOjuoko/AssemblyRobot/Pin parts/Pin holderSTL.STL

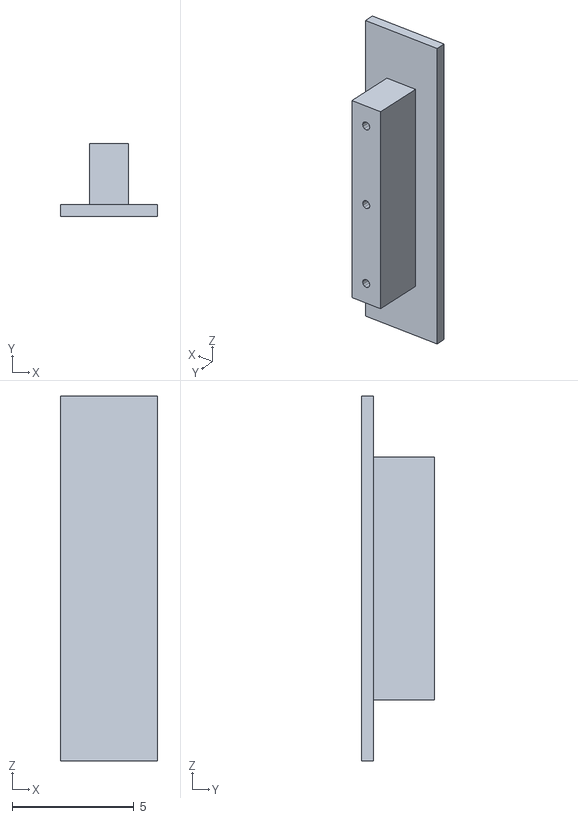
[picture p57: CAD file, 2022-12-14]
Pin parts/Pin holderSTL.STL
4.00 x 3.00 x 15.0
