SeunOjuoko/AssemblyRobot/Final CAD/PARTS FOR PRINT (STL)/EndConnector.STL

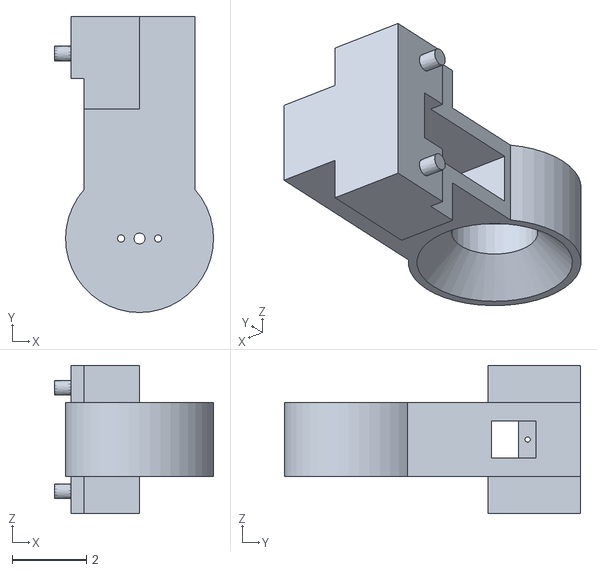
[picture p58: CAD file, 2022-12-14]
Final CAD/PARTS FOR PRINT (STL)/EndConnector.STL
4.30 x 8.00 x 4.00
