SeunOjuoko/AssemblyRobot/Final CAD/PARTS FOR PRINT (STL)/NBase top.STL

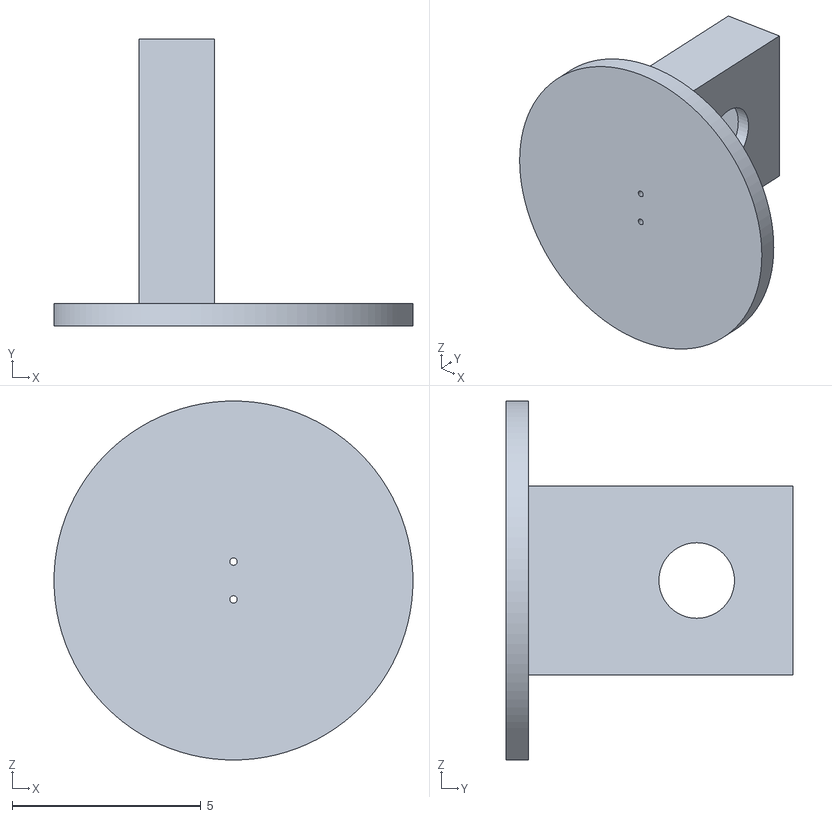
[picture p59: CAD file, 2022-12-14]
Final CAD/PARTS FOR PRINT (STL)/NBase top.STL
9.50 x 7.60 x 9.50
