SeunOjuoko/AssemblyRobot/(list of files, cad)

Other CAD files:
NewEndParts/Teeth ends/NewConceptArm servo teeth.stl
NewEndParts/Been Printed/NewConceptArm free.STL
NewEndParts/New Shape (V2) Ends/NewConceptArm servo V2.stl
NewEndParts/Teeth ends/NewConceptArm free teeth.stl
15_Supportingfiles/Robot Arm CAD Files/1stArm.ipt
15_Supportingfiles/Robot Arm CAD Files/2ndArm.ipt
15_Supportingfiles/Robot Arm CAD Files/Base top w servo housing.ipt
15_Supportingfiles/Robot Arm CAD Files/FinalNewbaseTop.ipt
15_Supportingfiles/Robot Arm CAD Files/Free gear.ipt
15_Supportingfiles/Robot Arm CAD Files/NBase Part.ipt
15_Supportingfiles/Robot Arm CAD Files/NeWConceptV2.0.ipt
15_Supportingfiles/Robot Arm CAD Files/RoboAssembly.iam
15_Supportingfiles/Robot Arm CAD Files/Servo new gear.ipt
CAD for Physical Build/1stArm.ipt
CAD for Physical Build/2ndArm.ipt
CAD for Physical Build/Base top w servo housing.ipt
CAD for Physical Build/Free gear.ipt
CAD for Physical Build/NBase Part.ipt
CAD for Physical Build/NeWConceptV2.0.ipt
CAD for Physical Build/Servo new gear.ipt
Final CAD/1stArm.ipt
Final CAD/2ndArm.ipt
Final CAD/Assembly (w filler).iam
Final CAD/EndConnector.ipt
Final CAD/NBase Part.ipt
Final CAD/NBase top.ipt
Final CAD/NeWConcept.ipt
Final CAD/New Gear.ipt
Final CAD/NewConceptArms.ipt
Final CAD/Old STL/2ndArm.STL
Final CAD/Old STL/NBase Part.STL
Final CAD/Old STL/NBase top.STL
Final CAD/Old/1stArm.ipt
Final CAD/Old/2ndArm.ipt
Final CAD/Old/Assembly w draft-end.iam
Final CAD/Old/Assembly w out end.iam
Final CAD/Old/EndConnector-draft.ipt
Final CAD/Old/Gear-Assembly-Draft.iam
Final CAD/Old/NBase Part.ipt
Final CAD/Old/NBase top.ipt
Final CAD/Pintingz/Cylinder.ipt
Final CAD/Pintingz/Pin holder.ipt
Final CAD/Pintingz/Pin.ipt
Final CAD/Solo (SG) Gear.ipt
Final CAD/filler.ipt
Final Grippers/Free gear.ipt
Final Grippers/Servo new gear.ipt
FinalNewbaseTop.ipt
NewEndParts/Base top w servo housing.ipt
NewEndParts/Been Printed/NeWConceptV2.0.ipt
NewEndParts/Been Printed/NewConceptArm free.ipt
NewEndParts/Been Printed/NewConceptArm servo.ipt
NewEndParts/New Shape (V2) Ends/NewConceptArm free V2.ipt
NewEndParts/New Shape (V2) Ends/NewConceptArm servo V2.ipt
NewEndParts/Teeth ends/NewConceptArm free teeth.ipt
NewEndParts/Teeth ends/NewConceptArm servo teeth.ipt
Old CAD Stuff/2nd CAD model/1st-arm.ipt
Old CAD Stuff/2nd CAD model/2nd arm.ipt
Old CAD Stuff/2nd CAD model/Assembly.iam
Old CAD Stuff/2nd CAD model/Base Part.ipt
Old CAD Stuff/2nd CAD model/BaseTop.ipt
Old CAD Stuff/2nd CAD model/EndConnector.ipt
Old CAD Stuff/2nd CAD model/STL/1st-arm.stl
Old CAD Stuff/2nd CAD model/STL/2nd arm.stl
Old CAD Stuff/2nd CAD model/STL/Base Part.stl
Old CAD Stuff/2nd CAD model/STL/BaseTop.stl
Old CAD Stuff/2nd CAD model/STL/EndConnector.stl
Old CAD Stuff/First CAD model/2nd arm.ipt
Old CAD Stuff/First CAD model/Base Top.ipt
Old CAD Stuff/First CAD model/End motor link.ipt
Old CAD Stuff/First CAD model/End.ipt
Old CAD Stuff/First CAD model/First arm.ipt
Old CAD Stuff/First CAD model/Version1Model.iam
Old CAD Stuff/First CAD model/new base.ipt
Pin parts/Pin Cylinder.ipt
Pin parts/Pin holder.ipt
Pin parts/Pin.ipt
